khoirilwafi/digital_audio_processor/eagle_pcb/dsp_processor/dlms_v1.brd

## EAGLE design eagle_pcb/dsp_processor/dlms_v1.brd (2023-06-03)

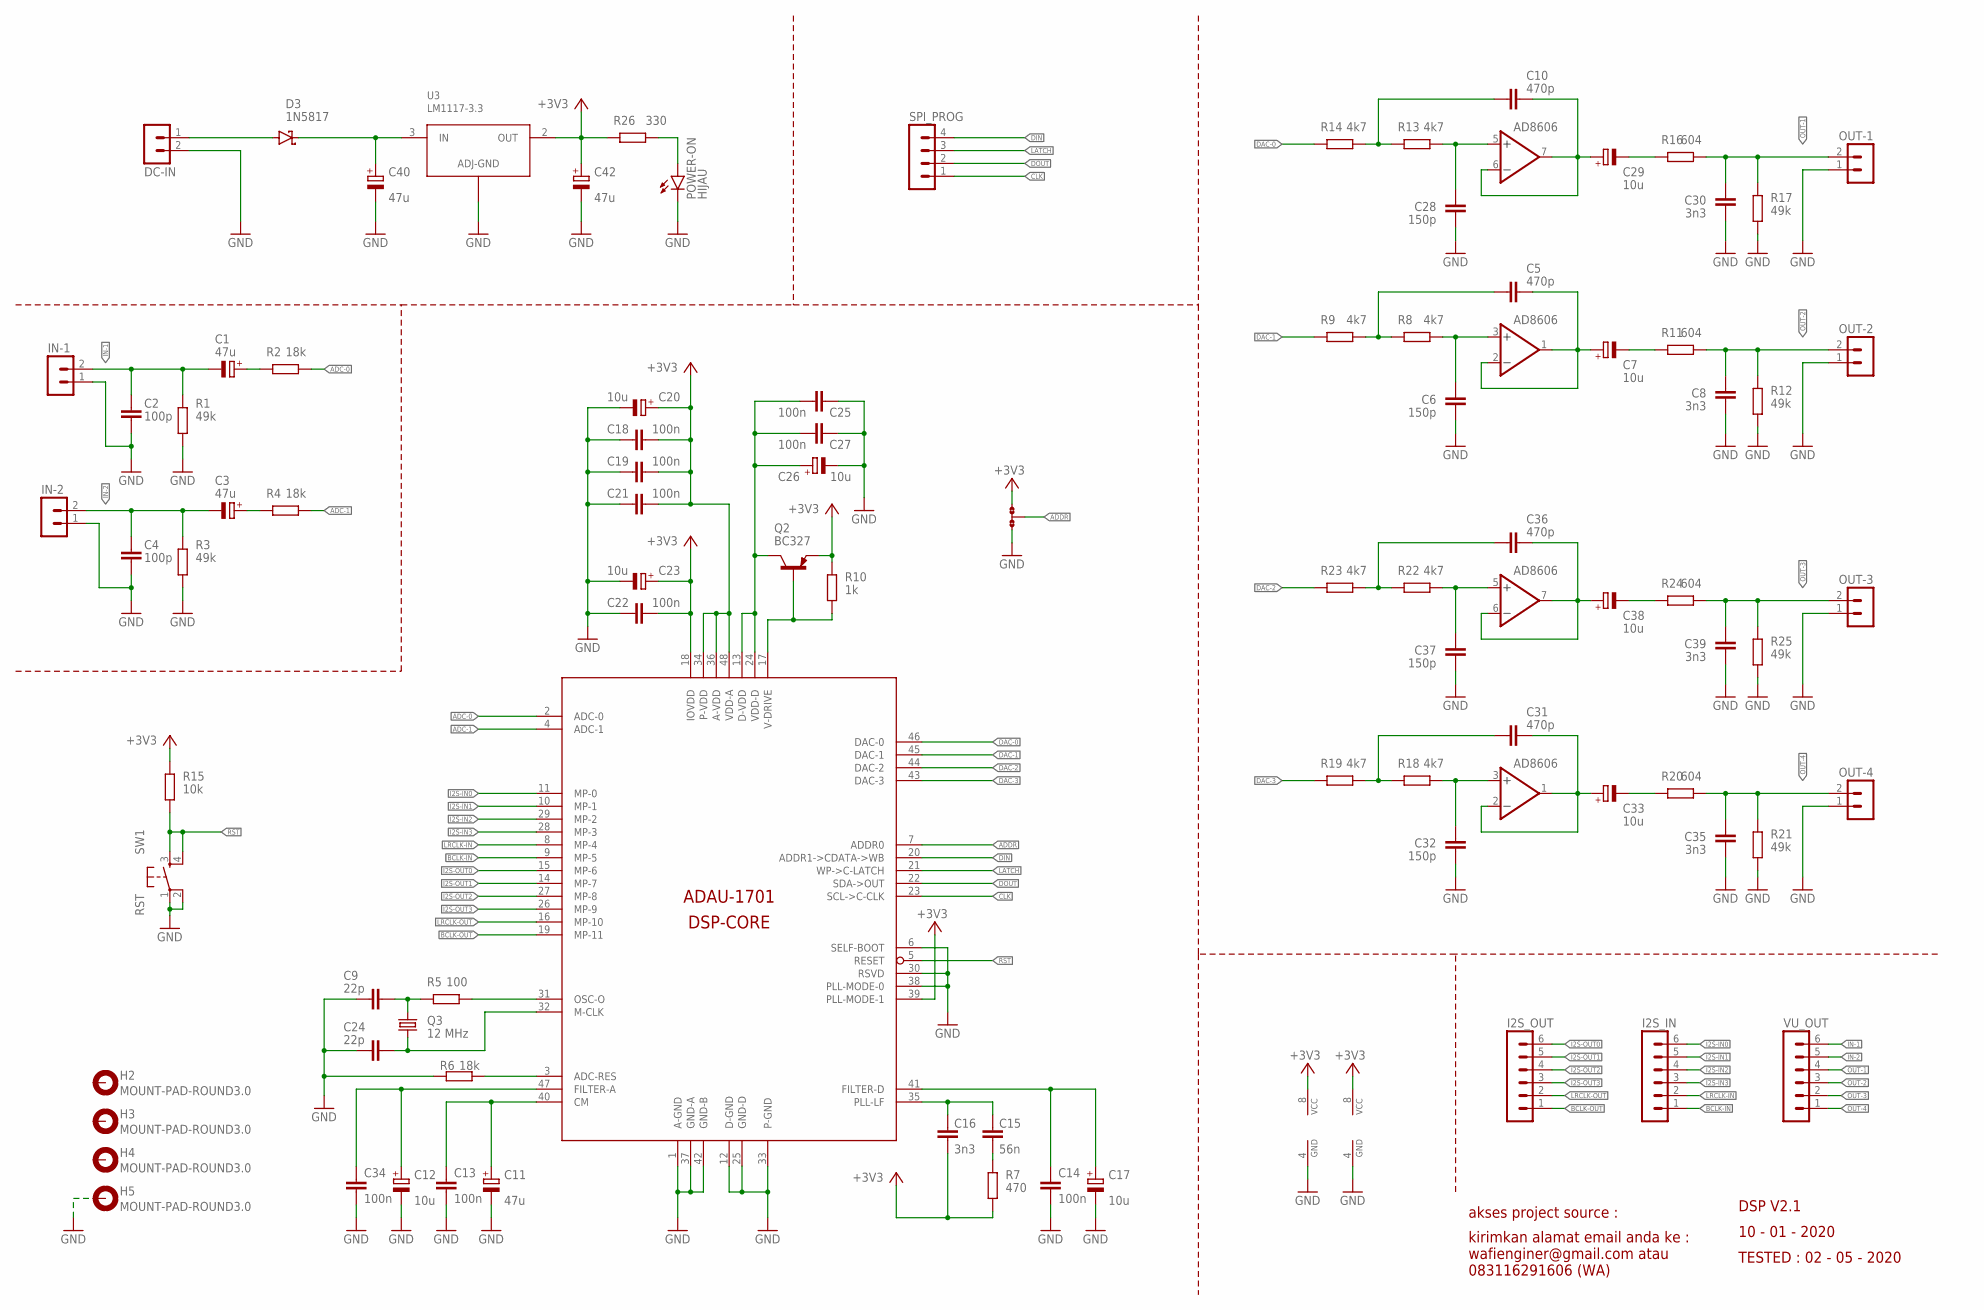
[picture p1: schematic dlms_v1.sch]

Parts:
ADDR: 0R-JUMPA; A0R-JMP
C1, C3, C11, C40, C42: 47u; E2,5-5
C2, C4: 100p; C050-024X044
C5, C10, C31, C36: 470p; C050-024X044
C6, C28, C32, C37: 150p; C050-024X044
C7, C12, C17, C20, C23, C26, C29, C33, C38: 10u; E2,5-5
C8, C16, C30, C35, C39: 3n3; C050-024X044
C9, C24: 22p; 0805
C13, C14, C18, C19, C21, C22, C25, C27, C34: 100n; 0805
C15: 56n; C050-024X044
D3: 1N5817; DO35Z7
DC-IN: MOLEX-2; 6410-02
H2, H3, H4, H5: MOUNT-PAD-ROUND3.0; 3,0-PAD
I2S_IN, I2S_OUT: MOLEX-6; 6410-06
IC1, IC2: AD8606; SOP8
IN-1, IN-2: MOLEX-2; 6410-02
OUT-1, OUT-2, OUT-3, OUT-4: MOLEX-2; 6410-02
POWER-ON: HIJAU; LED3MM
Q2: BC327; TO92-EBC
Q3: 12 MHz; HC49UP
R1, R3, R12, R17, R21, R25: 49k; 0204/7
R2, R4, R6: 18k; 0204/7
R5: 100; 0204/7
R7: 470; 0204/7
R8, R9, R13, R14, R18, R19, R22, R23: 4k7; 0204/7
R10: 1k; 0204/7
R11, R16, R20, R24: 604; 0204/7
R15: 10k; 0204/7
R26: 330; 0204/7
RST: SW1; B3F-10XX
SPI_PROG: MOLEX-4; 6410-04
U1: ADAU-1701; LQFP-48
U3: LM1117-3.3; TO220H
VU_OUT: MOLEX-6; 6410-06

Connections:
+3V3: ADDR.1, C16.2, C18.P$1 (1), C19.P$1 (1), C20.+, C21.P$1 (1), C22.P$1 (1), C23.+, C42.+, IC1.8 (VCC), IC2.8 (VCC), Q2.E, R7.1, R10.2, R15.2, R26.1, U1.18 (IOVDD), U1.34 (P-VDD), U1.36 (A-VDD), U1.39 (PLL-MODE-1), U1.48 (VDD-A), U3.2 (OUT)
ADC-0: R2.2, U1.2 (ADC-0)
ADC-1: R4.2, U1.4 (ADC-1)
ADDR: ADDR.2, U1.7 (ADDR0)
BCLK-IN: I2S_IN.1, U1.9 (MP-5)
BCLK-OUT: I2S_OUT.1, U1.19 (MP-11)
CLK: SPI_PROG.1, U1.23 (SCL->C-CLK)
CM: C11.+, C13.P$1 (1), U1.40 (CM)
DAC-0: R14.1, U1.46 (DAC-0)
DAC-1: R9.1, U1.45 (DAC-1)
DAC-2: R23.1, U1.44 (DAC-2)
DAC-3: R19.1, U1.43 (DAC-3)
DIN: SPI_PROG.4, U1.20 (ADDR1->CDATA->WB)
DOUT: SPI_PROG.2, U1.22 (SDA->OUT)
DVDD: C25.P$1 (1), C26.+, C27.P$1 (1), Q2.C, U1.13 (D-VDD), U1.24 (VDD-D)
FIL-A: C12.+, C34.P$1 (1), U1.47 (FILTER-A)
FIL-D: C14.P$1 (1), C17.+, U1.41 (FILTER-D)
GND: ADDR.3, C2.2, C4.2, C6.1, C8.2, C9.P$2 (2), C11.-, C12.-, C13.P$2 (2), C14.P$2 (2), C17.-, C18.P$2 (2), C19.P$2 (2), C20.-, C21.P$2 (2), C22.P$2 (2), C23.-, C24.P$2 (2), C25.P$2 (2), C26.-, C27.P$2 (2), C28.1, C30.2, C32.1, C34.P$2 (2), C35.2, C37.1, C39.2, C40.-, C42.-, DC-IN.2, H5.B3,0, IC1.4 (GND), IC2.4 (GND), IN-1.1, IN-2.1, OUT-1.1, OUT-2.1, OUT-3.1, OUT-4.1, POWER-ON.K (C), R1.1, R3.1, R6.1, R12.1, R17.1, R21.1, R25.1, RST.1, RST.2 (P1), U1.1 (A-GND), U1.6 (SELF-BOOT), U1.12 (D-GND), U1.25 (GND-D), U1.30 (RSVD), U1.33 (P-GND), U1.37 (GND-A), U1.38 (PLL-MODE-0), U1.42 (GND-B), U3.1 (GND)
I2S-IN0: I2S_IN.6, U1.11 (MP-0)
I2S-IN1: I2S_IN.5, U1.10 (MP-1)
I2S-IN2: I2S_IN.4, U1.29 (MP-2)
I2S-IN3: I2S_IN.3, U1.28 (MP-3)
I2S-OUT0: I2S_OUT.6, U1.15 (MP-6)
I2S-OUT1: I2S_OUT.5, U1.14 (MP-7)
I2S-OUT2: I2S_OUT.4, U1.27 (MP-8)
I2S-OUT3: I2S_OUT.3, U1.26 (MP-9)
IN-1: C1.-, C2.1, IN-1.2, R1.2, VU_OUT.6
IN-2: C3.-, C4.1, IN-2.2, R3.2, VU_OUT.5
LATCH: SPI_PROG.3, U1.21 (WP->C-LATCH)
LRCLK-IN: I2S_IN.2, U1.8 (MP-4)
LRCLK-OUT: I2S_OUT.2, U1.16 (MP-10)
unnamed: C1.+, R2.1
unnamed: C3.+, R4.1
unnamed: C5.1, R8.1, R9.2
unnamed: C6.2, IC1.3 (+IN), R8.2
unnamed: C5.2, C7.+, IC1.1 (OUT), IC1.2 (-IN)
unnamed: C7.-, R11.1
unnamed: C10.1, R13.1, R14.2
unnamed: C9.P$1 (1), Q3.2, R5.1
unnamed: C24.P$1 (1), Q3.1, U1.32 (M-CLK)
unnamed: R5.2, U1.31 (OSC-O)
unnamed: C28.2, IC1.5 (+IN), R13.2
unnamed: C10.2, C29.+, IC1.6 (-IN), IC1.7 (OUT)
unnamed: R6.2, U1.3 (ADC-RES)
unnamed: C29.-, R16.1
unnamed: C15.2, R7.2
unnamed: C31.1, R18.1, R19.2
unnamed: C32.2, IC2.3 (+IN), R18.2
unnamed: C31.2, C33.+, IC2.1 (OUT), IC2.2 (-IN)
unnamed: C33.-, R20.1
unnamed: C36.1, R22.1, R23.2
unnamed: C37.2, IC2.5 (+IN), R22.2
unnamed: C36.2, C38.+, IC2.6 (-IN), IC2.7 (OUT)
unnamed: C38.-, R24.1
unnamed: C40.+, D3.C, U3.3 (IN)
unnamed: POWER-ON.A, R26.2
OUT-1: C30.1, OUT-1.2, R16.2, R17.2, VU_OUT.4
OUT-2: C8.1, OUT-2.2, R11.2, R12.2, VU_OUT.3
OUT-3: C39.1, OUT-3.2, R24.2, R25.2, VU_OUT.2
OUT-4: C35.1, OUT-4.2, R20.2, R21.2, VU_OUT.1
PLL-LF: C15.1, C16.1, U1.35 (PLL-LF)
RST: R15.1, RST.3 (S), RST.4 (S1), U1.5 (RESET)
VDRIVE: Q2.B, R10.1, U1.17 (V-DRIVE)
VIN: D3.A, DC-IN.1

Notes on the sheet:
akses project source :
kirimkan alamat email anda ke : wafienginer@gmail.com atau 083116291606 (WA)
DSP V2.1
10 - 01 - 2020
TESTED : 02 - 05 - 2020

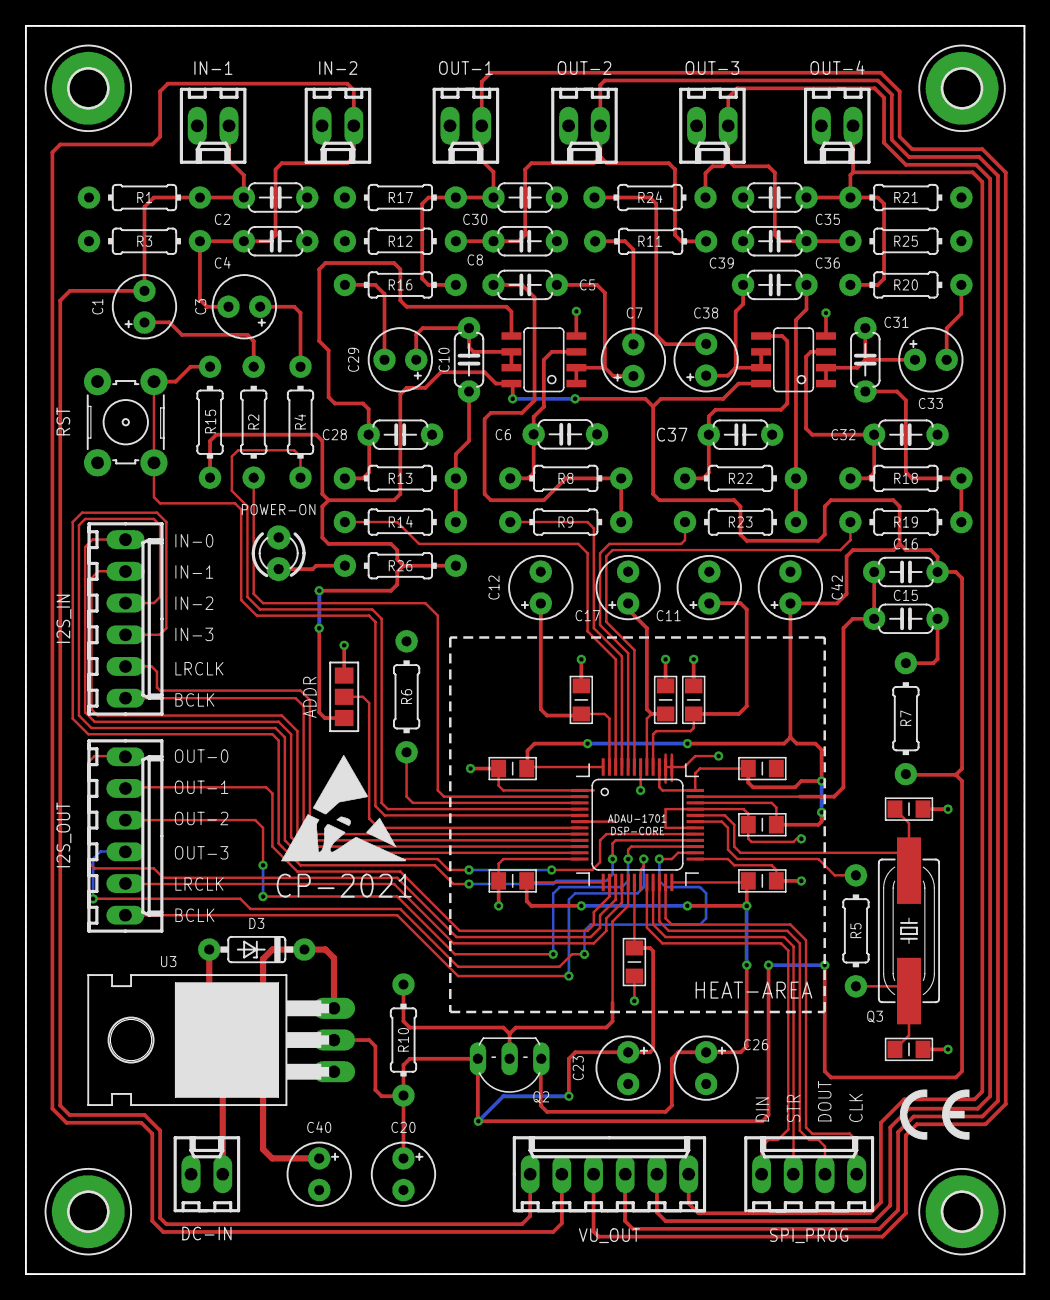
[picture p2: board dlms_v1.brd from above]

Board: 2 copper layers, 80.0 x 100.0 mm, 94 parts (0 on the bottom side), 64 nets.

Other parts of the board:
U$2: CE-4MM
U$3: ESD_10.00
