khoirilwafi/digital_audio_processor/eagle_pcb/dsp_controller/control.brd

## EAGLE design eagle_pcb/dsp_controller/control.brd (2023-06-03)

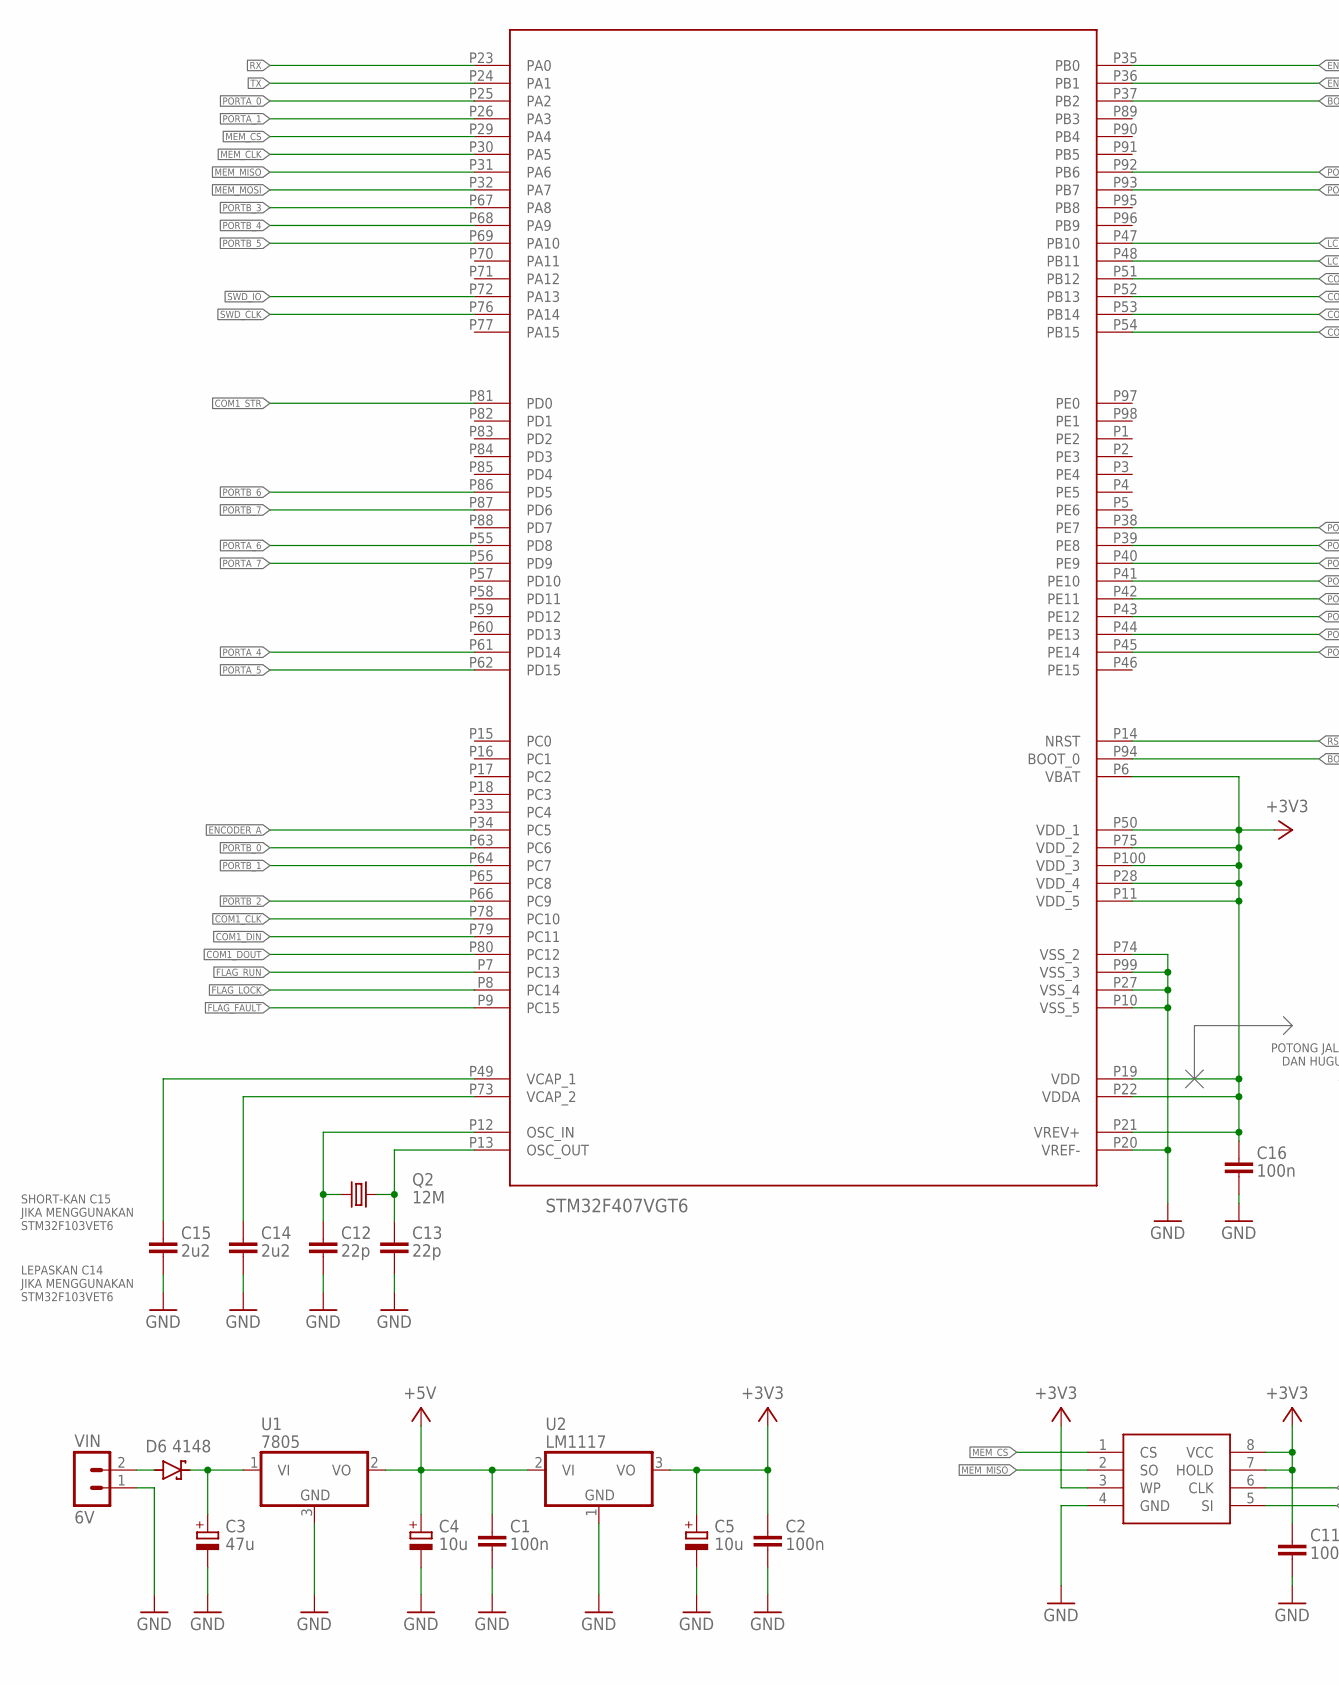
[picture p3: schematic control.sch, part in row 1, column 1]

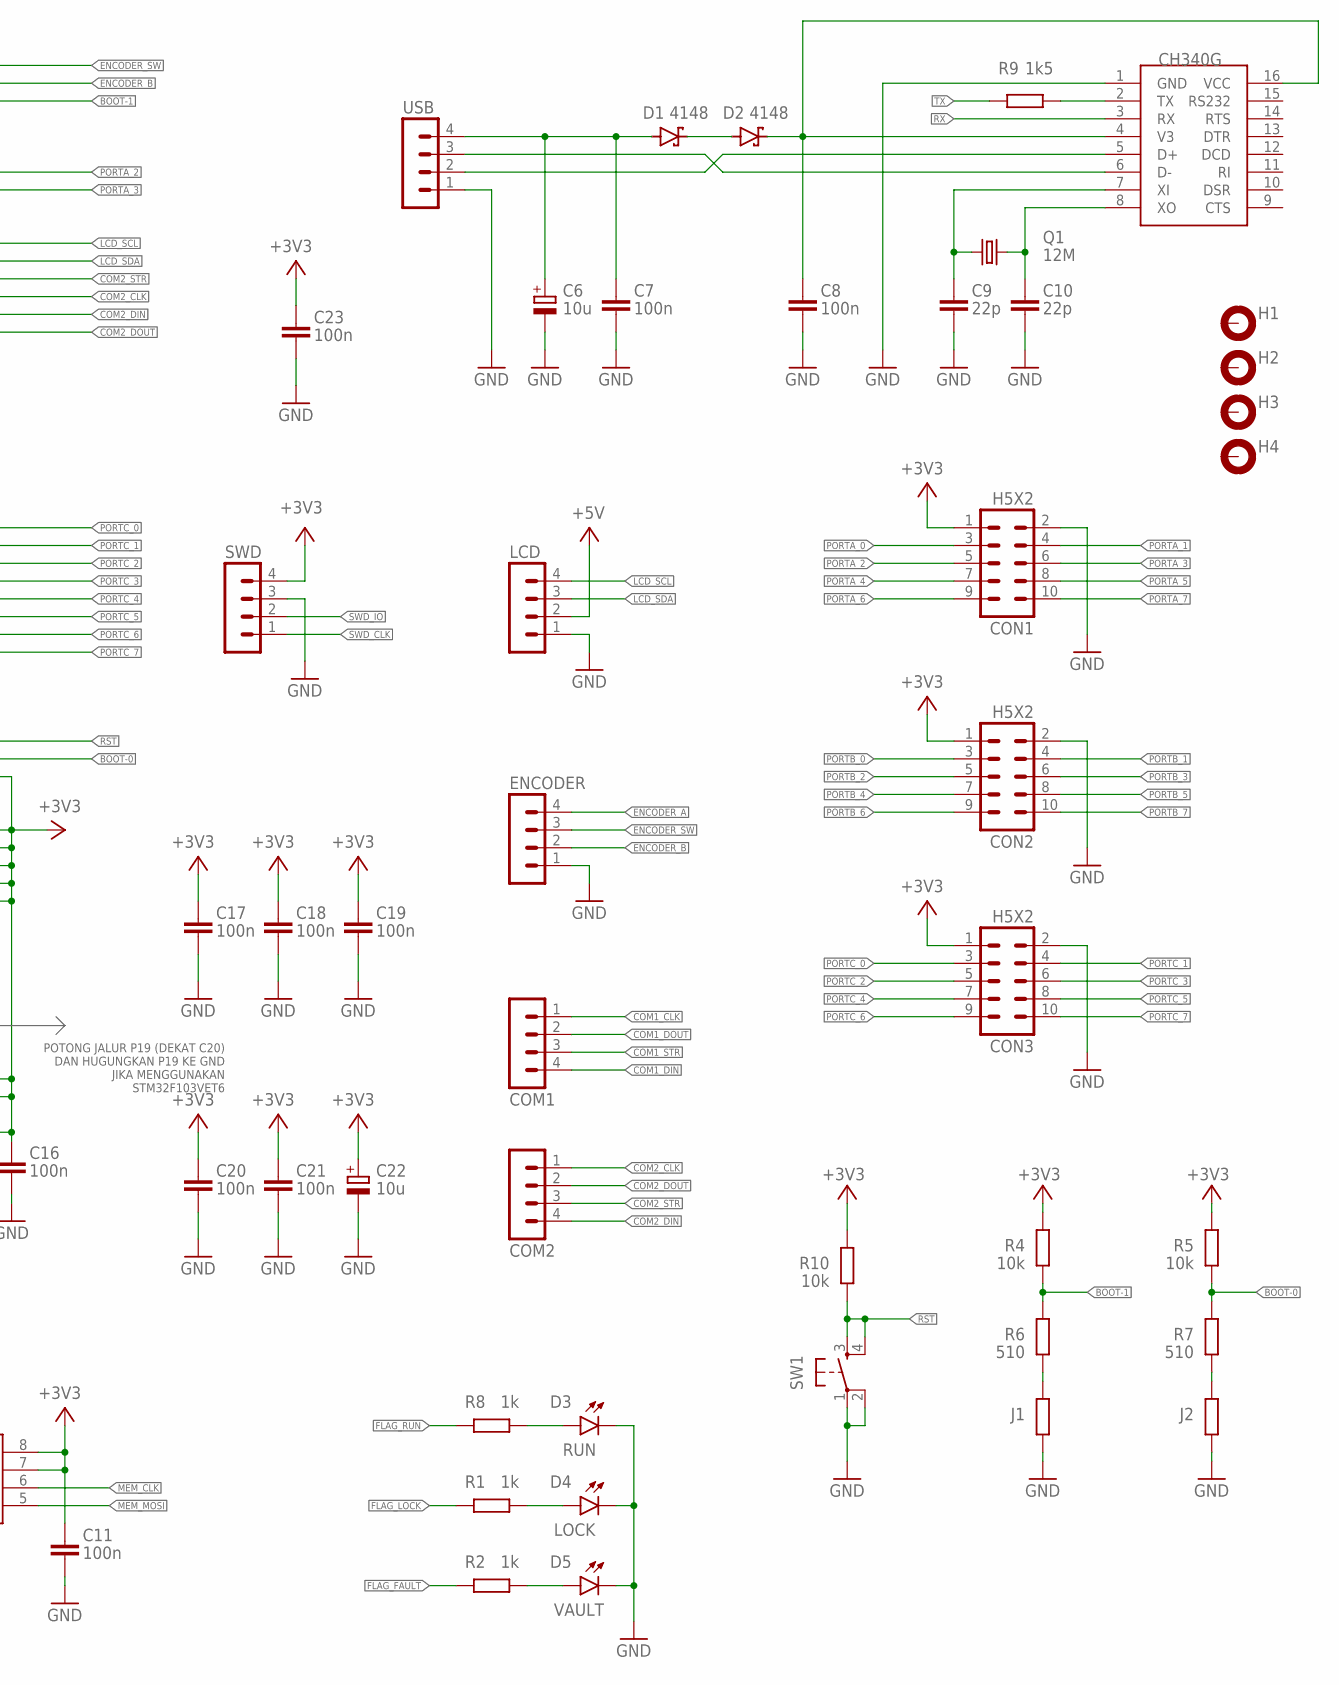
[picture p4: schematic control.sch, part in row 1, column 2]

Parts:
C1, C2, C7, C8, C11, C16, C17, C18, C19, C20, C21, C23: 100n; 0805
C3: 47u; E2,5-5
C4, C5, C6, C22: 10u; E2,5-5
C9, C10, C12, C13: 22p; 0805
C14, C15: 2u2; 0805
COM1, COM2: MOLEX-4; 6410-04
CON1, CON2, CON3: H5X2; MA05-2
D1, D2, D6: 4148; DO35Z7
D3: RUN; LED3MM
D4: LOCK; LED3MM
D5: VAULT; LED3MM
ENCODER: MOLEX-4; 6410-04
H1, H2, H3, H4: MOUNT-PAD-ROUND3.0; 3,0-PAD
J1, J2: 10k; 0805
LCD: MOLEX-4; 6410-04
Q1, Q2: 12M; HC49/S
R1, R2, R8: 1k; 0805
R4, R5, R10: 10k; 0805
R6, R7: 510; 0805
R9: 1k5; 0204/7
SW1: SW; B3F-10XX
SWD: MOLEX-4; 6410-04
U1: 7805; TO252
U2: LM1117; TO252
U3: W25QXX; SOP8
U4: STM32F407; LQFP100
U$1: CH340G; SOIC16
USB: MOLEX-4; 6410-04
VIN: 6V; 6410-02

Connections:
+3V3: C2.P$1 (1), C5.+, C11.P$1 (1), C16.P$1 (1), C17.P$1 (1), C18.P$1 (1), C19.P$1 (1), C20.P$1 (1), C21.P$1 (1), C22.+, C23.P$1 (1), CON1.1, CON2.1, CON3.1, R4.P$2 (2), R5.P$2 (2), R10.P$2 (2), SWD.4, U2.3 (VO), U3.3 (WP), U3.7 (HOLD), U3.8 (VCC), U4.P6 (VBAT), U4.P11 (VDD_5), U4.P19 (VDD), U4.P21 (VREV+), U4.P22 (VDDA), U4.P28 (VDD_4), U4.P50 (VDD_1), U4.P75 (VDD_2), U4.P100 (VDD_3)
+5V: C1.P$1 (1), C4.+, LCD.2, U1.2 (VO), U2.2 (VI)
BOOT-0: R5.P$1 (1), R7.P$2 (2), U4.P94 (BOOT_0)
BOOT-1: R4.P$1 (1), R6.P$2 (2), U4.P37 (PB2)
COM1_CLK: COM1.1, U4.P78 (PC10)
COM1_DIN: COM1.4, U4.P79 (PC11)
COM1_DOUT: COM1.2, U4.P80 (PC12)
COM1_STR: COM1.3, U4.P81 (PD0)
COM2_CLK: COM2.1, U4.P52 (PB13)
COM2_DIN: COM2.4, U4.P53 (PB14)
COM2_DOUT: COM2.2, U4.P54 (PB15)
COM2_STR: COM2.3, U4.P51 (PB12)
ENCODER_A: ENCODER.4, U4.P34 (PC5)
ENCODER_B: ENCODER.2, U4.P36 (PB1)
ENCODER_SW: ENCODER.3, U4.P35 (PB0)
FLAG_FAULT: R2.P$2 (2), U4.P9 (PC15)
FLAG_LOCK: R1.P$2 (2), U4.P8 (PC14)
FLAG_RUN: R8.P$2 (2), U4.P7 (PC13)
GND: C1.P$2 (2), C2.P$2 (2), C3.-, C4.-, C5.-, C6.-, C7.P$2 (2), C8.P$2 (2), C9.P$2 (2), C10.P$2 (2), C11.P$2 (2), C12.P$2 (2), C13.P$2 (2), C14.P$2 (2), C15.P$2 (2), C16.P$2 (2), C17.P$2 (2), C18.P$2 (2), C19.P$2 (2), C20.P$2 (2), C21.P$2 (2), C22.-, C23.P$2 (2), CON1.2, CON2.2, CON3.2, D3.K (C), D4.K (C), D5.K (C), ENCODER.1, J1.P$1 (1), J2.P$1 (1), LCD.1, SW1.1, SW1.2 (P1), SWD.3, U1.3 (GND), U2.1 (GND), U3.4 (GND), U4.P10 (VSS_5), U4.P20 (VREF-), U4.P27 (VSS_4), U4.P74 (VSS_2), U4.P99 (VSS_3), U$1.1 (GND), USB.1, VIN.1
LCD_SCL: LCD.4, U4.P47 (PB10)
LCD_SDA: LCD.3, U4.P48 (PB11)
MEM_CLK: U3.6 (CLK), U4.P30 (PA5)
MEM_CS: U3.1 (CS), U4.P29 (PA4)
MEM_MISO: U3.2 (SO), U4.P31 (PA6)
MEM_MOSI: U3.5 (SI), U4.P32 (PA7)
unnamed: C3.+, D6.C, U1.1 (VI)
unnamed: C6.+, C7.P$1 (1), D1.A, USB.4
unnamed: D1.C, D2.A
unnamed: C8.P$1 (1), D2.C, U$1.4 (V3), U$1.16 (VCC)
unnamed: U$1.6 (D-), USB.3
unnamed: U$1.5 (D+), USB.2
unnamed: C9.P$1 (1), Q1.1, U$1.7 (XI)
unnamed: C10.P$1 (1), Q1.2, U$1.8 (XO)
unnamed: D5.A, R2.P$1 (1)
unnamed: D4.A, R1.P$1 (1)
unnamed: D3.A, R8.P$1 (1)
unnamed: C12.P$1 (1), Q2.1, U4.P12 (OSC_IN)
unnamed: C13.P$1 (1), Q2.2, U4.P13 (OSC_OUT)
unnamed: C14.P$1 (1), U4.P73 (VCAP_2)
unnamed: C15.P$1 (1), U4.P49 (VCAP_1)
unnamed: D6.A, VIN.2
unnamed: J1.P$2 (2), R6.P$1 (1)
unnamed: J2.P$2 (2), R7.P$1 (1)
unnamed: R9.2, U$1.2 (TX)
PORTA_0: CON1.3, U4.P25 (PA2)
PORTA_1: CON1.4, U4.P26 (PA3)
PORTA_2: CON1.5, U4.P92 (PB6)
PORTA_3: CON1.6, U4.P93 (PB7)
PORTA_4: CON1.7, U4.P61 (PD14)
PORTA_5: CON1.8, U4.P62 (PD15)
PORTA_6: CON1.9, U4.P55 (PD8)
PORTA_7: CON1.10, U4.P56 (PD9)
PORTB_0: CON2.3, U4.P63 (PC6)
PORTB_1: CON2.4, U4.P64 (PC7)
PORTB_2: CON2.5, U4.P66 (PC9)
PORTB_3: CON2.6, U4.P67 (PA8)
PORTB_4: CON2.7, U4.P68 (PA9)
PORTB_5: CON2.8, U4.P69 (PA10)
PORTB_6: CON2.9, U4.P86 (PD5)
PORTB_7: CON2.10, U4.P87 (PD6)
PORTC_0: CON3.3, U4.P38 (PE7)
PORTC_1: CON3.4, U4.P39 (PE8)
PORTC_2: CON3.5, U4.P40 (PE9)
PORTC_3: CON3.6, U4.P41 (PE10)
PORTC_4: CON3.7, U4.P42 (PE11)
PORTC_5: CON3.8, U4.P43 (PE12)
PORTC_6: CON3.9, U4.P44 (PE13)
PORTC_7: CON3.10, U4.P45 (PE14)
RST: R10.P$1 (1), SW1.3 (S), SW1.4 (S1), U4.P14 (NRST)
RX: U4.P23 (PA0), U$1.3 (RX)
SWD_CLK: SWD.1, U4.P76 (PA14)
SWD_IO: SWD.2, U4.P72 (PA13)
TX: R9.1, U4.P24 (PA1)

Notes on the sheet:
STM32F407VGT6
SHORT-KAN C15 JIKA MENGGUNAKAN STM32F103VET6
LEPASKAN C14 JIKA MENGGUNAKAN STM32F103VET6
POTONG JALUR P19 (DEKAT C20) DAN HUGUNGKAN P19 KE GND JIKA MENGGUNAKAN STM32F103VET6

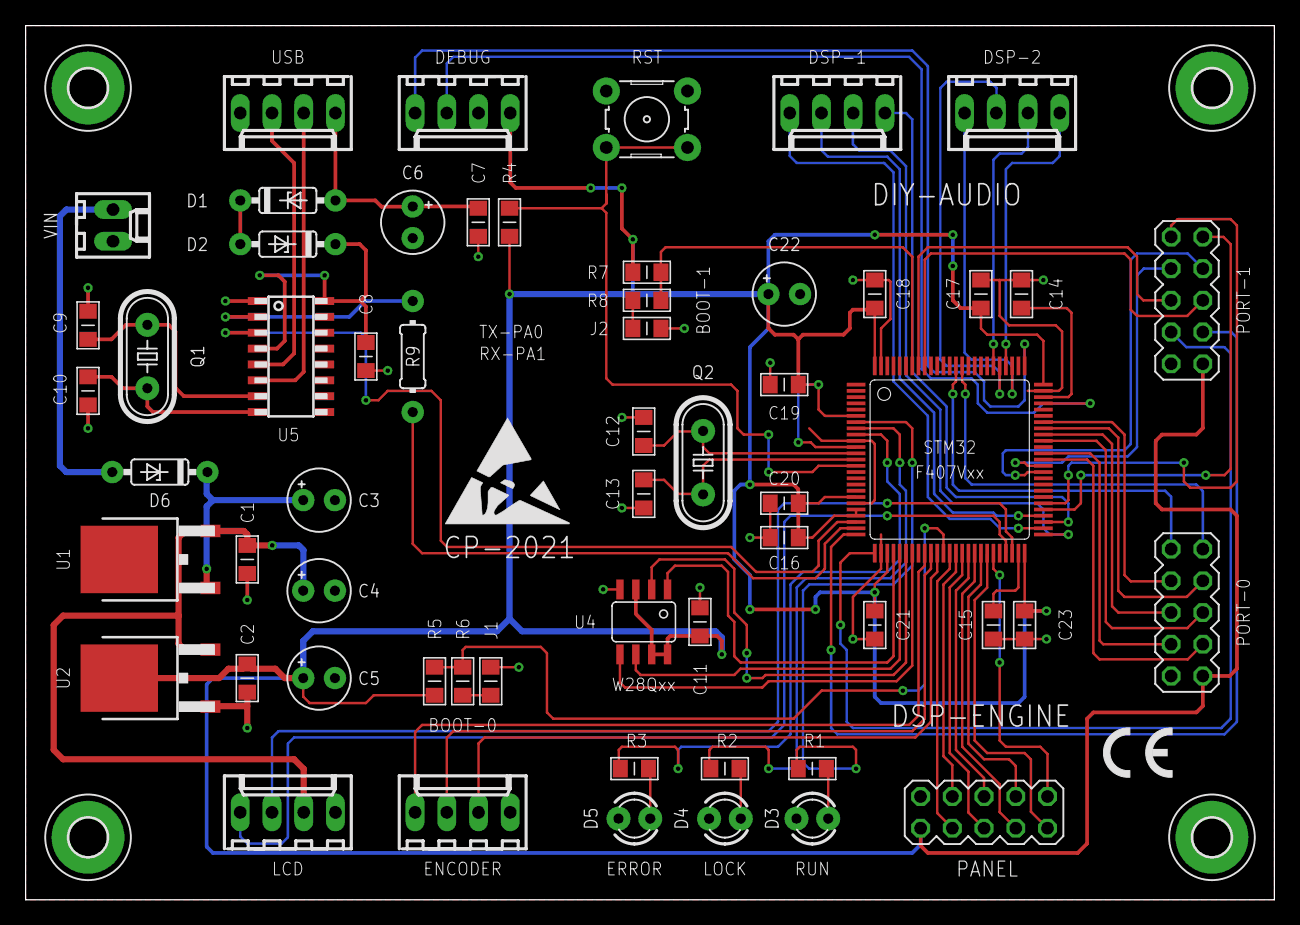
[picture p5: board control.brd from above]

Board: 2 copper layers, 100.0 x 70.0 mm, 64 parts (0 on the bottom side), 73 nets.

Other parts of the board:
E$1: ESD_10.00
U$2: CE-4MM
