khoirilwafi/digital_audio_processor/stm32/new_module/Core/Src/main.c

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
/* Includes ------------------------------------------------------------------*/
#include "main.h"

/* USER CODE BEGIN Includes */
#include "lcd_16x2_i2c.h"
#include "interface.h"
#include "dsp_processor.h"
#include "internal_data.h"
#include "external_flash.h"
/* USER CODE END Includes */

I2C_HandleTypeDef hi2c2;

SPI_HandleTypeDef hspi1;
SPI_HandleTypeDef hspi2;

TIM_HandleTypeDef htim1;
TIM_HandleTypeDef htim2;

/* USER CODE BEGIN PV */
extern int8_t mod;
extern uint8_t channel;
extern uint8_t page, sub_page;
extern uint8_t pos, prev, layer;
extern bool lcd_refresh;
extern bool setting;
extern bool mute[6];
/* USER CODE END PV */

void SystemClock_Config(void);
static void MX_GPIO_Init(void);
static void MX_I2C2_Init(void);
static void MX_SPI2_Init(void);
static void MX_SPI1_Init(void);
static void MX_TIM1_Init(void);
static void MX_TIM2_Init(void);
/**
  * @brief  The application entry point.
  * @retval int
  */
int main(void)
{
  /* MCU Configuration--------------------------------------------------------*/

  /* Reset of all peripherals, Initializes the Flash interface and the Systick. */
  HAL_Init();

  /* Configure the system clock */
  SystemClock_Config();

  /* Initialize all configured peripherals */
  MX_GPIO_Init();
  MX_I2C2_Init();
  MX_SPI2_Init();
  MX_SPI1_Init();
  MX_TIM1_Init();
  MX_TIM2_Init();
  /* USER CODE BEGIN 2 */

  HAL_GPIO_WritePin(LOCK_GPIO_Port, LOCK_Pin, GPIO_PIN_SET);
  HAL_GPIO_WritePin(ERROR_GPIO_Port, ERROR_Pin, GPIO_PIN_SET);
  HAL_GPIO_WritePin(RUN_GPIO_Port, RUN_Pin, GPIO_PIN_SET);

	HAL_Delay(500);
	HAL_GPIO_WritePin(DSP_RST_GPIO_Port, DSP_RST_Pin, GPIO_PIN_RESET);
	HAL_Delay(500);
	HAL_GPIO_WritePin(DSP_RST_GPIO_Port, DSP_RST_Pin, GPIO_PIN_SET);

	interface_begin();
	loading_procedure();

	HAL_TIM_Base_Start_IT(&htim2);
	HAL_Delay(500);

  	// cek koneksi lcd
  	uint8_t ret = HAL_I2C_IsDeviceReady(&hi2c2, 0x27<<1, 10, 100);

  	if(ret != HAL_OK)
  	{
  		Error_Handler();
  	}

  	uint16_t id = flash_read_id();

  	if((id == 0x00) || (id != 0xEF17))
  	{
  		lcd_clear();
  		lcd_set_cursor(0,0); lcd_print("ERROR FLASH");
  		lcd_set_cursor(0,1); lcd_print("TIDAK DITEMUKAN");

  		Error_Handler();
  	}

  	uint32_t handshake[4] = { 0x00, 0x18, 0x08, 0x00 };

  	for(uint8_t i=0; i<4; i++)
  	{
  		if(flash_read_byte(0x020000+i) != handshake[i])
  		{
  			lcd_clear();
  			lcd_set_cursor(0,0); lcd_print("ERROR");
  			lcd_set_cursor(0,1); lcd_print("FLASH CORRUPT");

  			Error_Handler();
  		}
  	}

  	// cek koneksi dsp
  	if(dsp_check_connection(0) != HAL_OK)
  	{
  		lcd_clear();
  		lcd_set_cursor(0,0); lcd_print("ERROR DSP");
  		lcd_set_cursor(0,1); lcd_print("TIDAK DITEMUKAN");

  		Error_Handler();
  	}

  	HAL_GPIO_WritePin(RUN_GPIO_Port, RUN_Pin, GPIO_PIN_SET);

  	lcd_clear();
  	interface_welcome();
  	dsp_unmute(0);

  	led_sel(0);
  	for(uint8_t i=0; i<6; i++)
  	{
  		led_mute(i, mute[i]);
  	}

  /* USER CODE END 2 */

  /* Infinite loop */
  /* USER CODE BEGIN WHILE */
  while (1)
  {
	  uint8_t nilai_tombol = baca_tombol();
	      	while(baca_tombol() != 0);

	      	switch(nilai_tombol)
	      	{
	  	  		case 1 : channel = 0; page = 1; sub_page = pos = 0; prev = 1; led_sel(0); lcd_refresh = true; lcd_clear(); break;
	  	  		case 2 : channel = 1; page = 1; sub_page = pos = 0; prev = 1; led_sel(1); lcd_refresh = true; lcd_clear(); break;
	  	  		case 3 : channel = 2; page = 2; sub_page = pos = 0; prev = 1; led_sel(2); lcd_refresh = true; lcd_clear(); break;
	  	  		case 4 : channel = 3; page = 2; sub_page = pos = 0; prev = 1; led_sel(3); lcd_refresh = true; lcd_clear(); break;
	  	  		case 5 : channel = 4; page = 2; sub_page = pos = 0; prev = 1; led_sel(4); lcd_refresh = true; lcd_clear(); break;
	  	  		case 6 : channel = 5; page = 2; sub_page = pos = 0; prev = 1; led_sel(5); lcd_refresh = true; lcd_clear(); break;
	  	  		case 7 :
	  	  			if(sub_page == 0)
	  	  			{
	  	  				if(mute[channel] == true){ mute[channel] = false; }
	  	  				else{ mute[channel] = true; }
	  	  				lcd_refresh = true;
	  	  			}
	  	  		break;
	  	  		case 8 :
	  	  			reset_parameter();
	  	  		break;
	  	  		case 9 :
	  	  			if(sub_page == 0){ sub_page = 1; }
	  	  			else{ sub_page = 0; }
	  	  			setting = false;
	  	  			lcd_refresh = true;
	  	  			lcd_clear();
	  	  		break;
	  	  		case 10 :
	  	  			save_parameter();
	  	  		break;
	      	}

	      	switch(page)
	      	{
	  	  		case 1 : page1(); break;
	  	  		case 2 : page2(); break;
	      	}
    /* USER CODE END WHILE */

    /* USER CODE BEGIN 3 */
  }
  /* USER CODE END 3 */
}

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
