khoirilwafi/digital_audio_processor/sigma_studio/dlms_fix_IC_1_PARAM.h

/*
 * File:           D:\final_project_file\audio_management\sigma_studio\dlms_fix_IC_1_PARAM.h
 *
 * Created:        Monday, June 28, 2021 9:38:38 AM
 * Description:    dlms_fix:IC 1 parameter RAM definitions.
 *
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
 * This software may only be used to program products purchased from
 * Analog Devices for incorporation by you into audio products that
 * are intended for resale to audio product end users. This software
 * may not be distributed whole or in any part to third parties.
 *
 * Copyright ©2021 Analog Devices, Inc. All rights reserved.
 */
#ifndef __DLMS_FIX_IC_1_PARAM_H__
#define __DLMS_FIX_IC_1_PARAM_H__


/* Module Gain_input1 - Gain*/
#define MOD_GAIN_INPUT1_COUNT                          1
#define MOD_GAIN_INPUT1_DEVICE                         "IC1"
#define MOD_GAIN_INPUT1_GAIN1940ALGNS2_ADDR            0
#define MOD_GAIN_INPUT1_GAIN1940ALGNS2_FIXPT           0x00800000
#define MOD_GAIN_INPUT1_GAIN1940ALGNS2_VALUE           SIGMASTUDIOTYPE_FIXPOINT_CONVERT(1)
#define MOD_GAIN_INPUT1_GAIN1940ALGNS2_TYPE            SIGMASTUDIOTYPE_FIXPOINT

/* Module Gain1_input2 - Gain*/
#define MOD_GAIN1_INPUT2_COUNT                         1
#define MOD_GAIN1_INPUT2_DEVICE                        "IC1"
#define MOD_GAIN1_INPUT2_GAIN1940ALGNS1_ADDR           1
#define MOD_GAIN1_INPUT2_GAIN1940ALGNS1_FIXPT          0x00800000
#define MOD_GAIN1_INPUT2_GAIN1940ALGNS1_VALUE          SIGMASTUDIOTYPE_FIXPOINT_CONVERT(1)
#define MOD_GAIN1_INPUT2_GAIN1940ALGNS1_TYPE           SIGMASTUDIOTYPE_FIXPOINT

/* Module DCB2 - DC Blocking*/
#define MOD_DCB2_COUNT                                 1
#define MOD_DCB2_DEVICE                                "IC1"
#define MOD_DCB2_DCBLOCKALGDOUBLEPREC2POLE_ADDR        2
#define MOD_DCB2_DCBLOCKALGDOUBLEPREC2POLE_FIXPT       0x007FFCB9
#define MOD_DCB2_DCBLOCKALGDOUBLEPREC2POLE_VALUE       SIGMASTUDIOTYPE_FIXPOINT_CONVERT(0.9999)
#define MOD_DCB2_DCBLOCKALGDOUBLEPREC2POLE_TYPE        SIGMASTUDIOTYPE_FIXPOINT

/* Module DCB2_2 - DC Blocking*/
#define MOD_DCB2_2_COUNT                               1
#define MOD_DCB2_2_DEVICE                              "IC1"
#define MOD_DCB2_2_DCBLOCKALGDOUBLEPREC1POLE_ADDR      3
#define MOD_DCB2_2_DCBLOCKALGDOUBLEPREC1POLE_FIXPT     0x007FFCB9
#define MOD_DCB2_2_DCBLOCKALGDOUBLEPREC1POLE_VALUE     SIGMASTUDIOTYPE_FIXPOINT_CONVERT(0.9999)
#define MOD_DCB2_2_DCBLOCKALGDOUBLEPREC1POLE_TYPE      SIGMASTUDIOTYPE_FIXPOINT

/* Module EQ-input1 - Parametric EQ*/
#define MOD_EQ_INPUT1_COUNT                            20
#define MOD_EQ_INPUT1_DEVICE                           "IC1"
#define MOD_EQ_INPUT1_ALG0_STAGE0_B0_ADDR              4
#define MOD_EQ_INPUT1_ALG0_STAGE0_B0_FIXPT             0x00800000
#define MOD_EQ_INPUT1_ALG0_STAGE0_B0_VALUE             SIGMASTUDIOTYPE_FIXPOINT_CONVERT(1)
#define MOD_EQ_INPUT1_ALG0_STAGE0_B0_TYPE              SIGMASTUDIOTYPE_FIXPOINT
#define MOD_EQ_INPUT1_ALG0_STAGE0_B1_ADDR              5
#define MOD_EQ_INPUT1_ALG0_STAGE0_B1_FIXPT             0x00000000
#define MOD_EQ_INPUT1_ALG0_STAGE0_B1_VALUE             SIGMASTUDIOTYPE_FIXPOINT_CONVERT(0)
#define MOD_EQ_INPUT1_ALG0_STAGE0_B1_TYPE              SIGMASTUDIOTYPE_FIXPOINT
#define MOD_EQ_INPUT1_ALG0_STAGE0_B2_ADDR              6
#define MOD_EQ_INPUT1_ALG0_STAGE0_B2_FIXPT             0x00000000
#define MOD_EQ_INPUT1_ALG0_STAGE0_B2_VALUE             SIGMASTUDIOTYPE_FIXPOINT_CONVERT(0)
#define MOD_EQ_INPUT1_ALG0_STAGE0_B2_TYPE              SIGMASTUDIOTYPE_FIXPOINT
#define MOD_EQ_INPUT1_ALG0_STAGE0_A0_ADDR              7
#define MOD_EQ_INPUT1_ALG0_STAGE0_A0_FIXPT             0x00000000
#define MOD_EQ_INPUT1_ALG0_STAGE0_A0_VALUE             SIGMASTUDIOTYPE_FIXPOINT_CONVERT(0)
#define MOD_EQ_INPUT1_ALG0_STAGE0_A0_TYPE              SIGMASTUDIOTYPE_FIXPOINT
#define MOD_EQ_INPUT1_ALG0_STAGE0_A1_ADDR              8
#define MOD_EQ_INPUT1_ALG0_STAGE0_A1_FIXPT             0x00000000
#define MOD_EQ_INPUT1_ALG0_STAGE0_A1_VALUE             SIGMASTUDIOTYPE_FIXPOINT_CONVERT(0)
#define MOD_EQ_INPUT1_ALG0_STAGE0_A1_TYPE              SIGMASTUDIOTYPE_FIXPOINT
#define MOD_EQ_INPUT1_ALG0_STAGE1_B0_ADDR              9
#define MOD_EQ_INPUT1_ALG0_STAGE1_B0_FIXPT             0x00800000
#define MOD_EQ_INPUT1_ALG0_STAGE1_B0_VALUE             SIGMASTUDIOTYPE_FIXPOINT_CONVERT(1)
#define MOD_EQ_INPUT1_ALG0_STAGE1_B0_TYPE              SIGMASTUDIOTYPE_FIXPOINT
#define MOD_EQ_INPUT1_ALG0_STAGE1_B1_ADDR              10
#define MOD_EQ_INPUT1_ALG0_STAGE1_B1_FIXPT             0x00000000
#define MOD_EQ_INPUT1_ALG0_STAGE1_B1_VALUE             SIGMASTUDIOTYPE_FIXPOINT_CONVERT(0)
#define MOD_EQ_INPUT1_ALG0_STAGE1_B1_TYPE              SIGMASTUDIOTYPE_FIXPOINT
#define MOD_EQ_INPUT1_ALG0_STAGE1_B2_ADDR              11
#define MOD_EQ_INPUT1_ALG0_STAGE1_B2_FIXPT             0x00000000
#define MOD_EQ_INPUT1_ALG0_STAGE1_B2_VALUE             SIGMASTUDIOTYPE_FIXPOINT_CONVERT(0)
#define MOD_EQ_INPUT1_ALG0_STAGE1_B2_TYPE              SIGMASTUDIOTYPE_FIXPOINT
#define MOD_EQ_INPUT1_ALG0_STAGE1_A0_ADDR              12
#define MOD_EQ_INPUT1_ALG0_STAGE1_A0_FIXPT             0x00000000
#define MOD_EQ_INPUT1_ALG0_STAGE1_A0_VALUE             SIGMASTUDIOTYPE_FIXPOINT_CONVERT(0)
#define MOD_EQ_INPUT1_ALG0_STAGE1_A0_TYPE              SIGMASTUDIOTYPE_FIXPOINT
#define MOD_EQ_INPUT1_ALG0_STAGE1_A1_ADDR              13
#define MOD_EQ_INPUT1_ALG0_STAGE1_A1_FIXPT             0x00000000
#define MOD_EQ_INPUT1_ALG0_STAGE1_A1_VALUE             SIGMASTUDIOTYPE_FIXPOINT_CONVERT(0)
#define MOD_EQ_INPUT1_ALG0_STAGE1_A1_TYPE              SIGMASTUDIOTYPE_FIXPOINT
#define MOD_EQ_INPUT1_ALG0_STAGE2_B0_ADDR              14
#define MOD_EQ_INPUT1_ALG0_STAGE2_B0_FIXPT             0x00800000
#define MOD_EQ_INPUT1_ALG0_STAGE2_B0_VALUE             SIGMASTUDIOTYPE_FIXPOINT_CONVERT(1)
#define MOD_EQ_INPUT1_ALG0_STAGE2_B0_TYPE              SIGMASTUDIOTYPE_FIXPOINT
#define MOD_EQ_INPUT1_ALG0_STAGE2_B1_ADDR              15
#define MOD_EQ_INPUT1_ALG0_STAGE2_B1_FIXPT             0x00000000
#define MOD_EQ_INPUT1_ALG0_STAGE2_B1_VALUE             SIGMASTUDIOTYPE_FIXPOINT_CONVERT(0)
#define MOD_EQ_INPUT1_ALG0_STAGE2_B1_TYPE              SIGMASTUDIOTYPE_FIXPOINT
#define MOD_EQ_INPUT1_ALG0_STAGE2_B2_ADDR              16
#define MOD_EQ_INPUT1_ALG0_STAGE2_B2_FIXPT             0x00000000
#define MOD_EQ_INPUT1_ALG0_STAGE2_B2_VALUE             SIGMASTUDIOTYPE_FIXPOINT_CONVERT(0)
#define MOD_EQ_INPUT1_ALG0_STAGE2_B2_TYPE              SIGMASTUDIOTYPE_FIXPOINT
#define MOD_EQ_INPUT1_ALG0_STAGE2_A0_ADDR              17
#define MOD_EQ_INPUT1_ALG0_STAGE2_A0_FIXPT             0x00000000
#define MOD_EQ_INPUT1_ALG0_STAGE2_A0_VALUE             SIGMASTUDIOTYPE_FIXPOINT_CONVERT(0)
#define MOD_EQ_INPUT1_ALG0_STAGE2_A0_TYPE              SIGMASTUDIOTYPE_FIXPOINT
#define MOD_EQ_INPUT1_ALG0_STAGE2_A1_ADDR              18
#define MOD_EQ_INPUT1_ALG0_STAGE2_A1_FIXPT             0x00000000
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
#define MOD_SELEKTOR_OUTPUT3_ALG0_STAGE1_MONOSWITCHNOSLEW_FIXPT 0x00800000
#define MOD_SELEKTOR_OUTPUT3_ALG0_STAGE1_MONOSWITCHNOSLEW_VALUE SIGMASTUDIOTYPE_FIXPOINT_CONVERT(1)
#define MOD_SELEKTOR_OUTPUT3_ALG0_STAGE1_MONOSWITCHNOSLEW_TYPE SIGMASTUDIOTYPE_FIXPOINT

/* Module selektor-output4 - Mono Switch Nx1*/
#define MOD_SELEKTOR_OUTPUT4_COUNT                     2
#define MOD_SELEKTOR_OUTPUT4_DEVICE                    "IC1"
#define MOD_SELEKTOR_OUTPUT4_ALG0_STAGE0_MONOSWITCHNOSLEW_ADDR 50
#define MOD_SELEKTOR_OUTPUT4_ALG0_STAGE0_MONOSWITCHNOSLEW_FIXPT 0x00000000
#define MOD_SELEKTOR_OUTPUT4_ALG0_STAGE0_MONOSWITCHNOSLEW_VALUE SIGMASTUDIOTYPE_FIXPOINT_CONVERT(0)
#define MOD_SELEKTOR_OUTPUT4_ALG0_STAGE0_MONOSWITCHNOSLEW_TYPE SIGMASTUDIOTYPE_FIXPOINT
#define MOD_SELEKTOR_OUTPUT4_ALG0_STAGE1_MONOSWITCHNOSLEW_ADDR 51
#define MOD_SELEKTOR_OUTPUT4_ALG0_STAGE1_MONOSWITCHNOSLEW_FIXPT 0x00800000
#define MOD_SELEKTOR_OUTPUT4_ALG0_STAGE1_MONOSWITCHNOSLEW_VALUE SIGMASTUDIOTYPE_FIXPOINT_CONVERT(1)
#define MOD_SELEKTOR_OUTPUT4_ALG0_STAGE1_MONOSWITCHNOSLEW_TYPE SIGMASTUDIOTYPE_FIXPOINT

/* Module phase-output1 - Signal Invert*/
#define MOD_PHASE_OUTPUT1_COUNT                        1
#define MOD_PHASE_OUTPUT1_DEVICE                       "IC1"
#define MOD_PHASE_OUTPUT1_EQ1940INVERT1GAIN_ADDR       52
#define MOD_PHASE_OUTPUT1_EQ1940INVERT1GAIN_FIXPT      0xFF800000
#define MOD_PHASE_OUTPUT1_EQ1940INVERT1GAIN_VALUE      SIGMASTUDIOTYPE_FIXPOINT_CONVERT(-1)
#define MOD_PHASE_OUTPUT1_EQ1940INVERT1GAIN_TYPE       SIGMASTUDIOTYPE_FIXPOINT

/* Module phase-output2 - Signal Invert*/
#define MOD_PHASE_OUTPUT2_COUNT                        1
#define MOD_PHASE_OUTPUT2_DEVICE                       "IC1"
#define MOD_PHASE_OUTPUT2_EQ1940INVERT2GAIN_ADDR       53
#define MOD_PHASE_OUTPUT2_EQ1940INVERT2GAIN_FIXPT      0xFF800000
#define MOD_PHASE_OUTPUT2_EQ1940INVERT2GAIN_VALUE      SIGMASTUDIOTYPE_FIXPOINT_CONVERT(-1)
#define MOD_PHASE_OUTPUT2_EQ1940INVERT2GAIN_TYPE       SIGMASTUDIOTYPE_FIXPOINT

/* Module phase-output3 - Signal Invert*/
#define MOD_PHASE_OUTPUT3_COUNT                        1
#define MOD_PHASE_OUTPUT3_DEVICE                       "IC1"
#define MOD_PHASE_OUTPUT3_EQ1940INVERT3GAIN_ADDR       54
#define MOD_PHASE_OUTPUT3_EQ1940INVERT3GAIN_FIXPT      0xFF800000
#define MOD_PHASE_OUTPUT3_EQ1940INVERT3GAIN_VALUE      SIGMASTUDIOTYPE_FIXPOINT_CONVERT(-1)
#define MOD_PHASE_OUTPUT3_EQ1940INVERT3GAIN_TYPE       SIGMASTUDIOTYPE_FIXPOINT

/* Module phase-output4 - Signal Invert*/
#define MOD_PHASE_OUTPUT4_COUNT                        1
#define MOD_PHASE_OUTPUT4_DEVICE                       "IC1"
#define MOD_PHASE_OUTPUT4_EQ1940INVERT4GAIN_ADDR       55
#define MOD_PHASE_OUTPUT4_EQ1940INVERT4GAIN_FIXPT      0xFF800000
#define MOD_PHASE_OUTPUT4_EQ1940INVERT4GAIN_VALUE      SIGMASTUDIOTYPE_FIXPOINT_CONVERT(-1)
#define MOD_PHASE_OUTPUT4_EQ1940INVERT4GAIN_TYPE       SIGMASTUDIOTYPE_FIXPOINT

/* Module Gain-output1 - Gain*/
#define MOD_GAIN_OUTPUT1_COUNT                         1
#define MOD_GAIN_OUTPUT1_DEVICE                        "IC1"
#define MOD_GAIN_OUTPUT1_GAIN1940ALGNS3_ADDR           56
#define MOD_GAIN_OUTPUT1_GAIN1940ALGNS3_FIXPT          0x00800000
#define MOD_GAIN_OUTPUT1_GAIN1940ALGNS3_VALUE          SIGMASTUDIOTYPE_FIXPOINT_CONVERT(1)
#define MOD_GAIN_OUTPUT1_GAIN1940ALGNS3_TYPE           SIGMASTUDIOTYPE_FIXPOINT

/* Module Gain-output2 - Gain*/
#define MOD_GAIN_OUTPUT2_COUNT                         1
#define MOD_GAIN_OUTPUT2_DEVICE                        "IC1"
#define MOD_GAIN_OUTPUT2_GAIN1940ALGNS4_ADDR           57
#define MOD_GAIN_OUTPUT2_GAIN1940ALGNS4_FIXPT          0x00800000
#define MOD_GAIN_OUTPUT2_GAIN1940ALGNS4_VALUE          SIGMASTUDIOTYPE_FIXPOINT_CONVERT(1)
#define MOD_GAIN_OUTPUT2_GAIN1940ALGNS4_TYPE           SIGMASTUDIOTYPE_FIXPOINT

/* Module Gain-output3 - Gain*/
#define MOD_GAIN_OUTPUT3_COUNT                         1
#define MOD_GAIN_OUTPUT3_DEVICE                        "IC1"
#define MOD_GAIN_OUTPUT3_GAIN1940ALGNS5_ADDR           58
#define MOD_GAIN_OUTPUT3_GAIN1940ALGNS5_FIXPT          0x00800000
#define MOD_GAIN_OUTPUT3_GAIN1940ALGNS5_VALUE          SIGMASTUDIOTYPE_FIXPOINT_CONVERT(1)
#define MOD_GAIN_OUTPUT3_GAIN1940ALGNS5_TYPE           SIGMASTUDIOTYPE_FIXPOINT

/* Module Gain-output4 - Gain*/
#define MOD_GAIN_OUTPUT4_COUNT                         1
#define MOD_GAIN_OUTPUT4_DEVICE                        "IC1"
#define MOD_GAIN_OUTPUT4_GAIN1940ALGNS6_ADDR           59
#define MOD_GAIN_OUTPUT4_GAIN1940ALGNS6_FIXPT          0x00800000
#define MOD_GAIN_OUTPUT4_GAIN1940ALGNS6_VALUE          SIGMASTUDIOTYPE_FIXPOINT_CONVERT(1)
#define MOD_GAIN_OUTPUT4_GAIN1940ALGNS6_TYPE           SIGMASTUDIOTYPE_FIXPOINT

/* Module DCB3 - DC Blocking*/
#define MOD_DCB3_COUNT                                 1
#define MOD_DCB3_DEVICE                                "IC1"
#define MOD_DCB3_DCBLOCKALGDOUBLEPREC3POLE_ADDR        60
#define MOD_DCB3_DCBLOCKALGDOUBLEPREC3POLE_FIXPT       0x007FFCB9
#define MOD_DCB3_DCBLOCKALGDOUBLEPREC3POLE_VALUE       SIGMASTUDIOTYPE_FIXPOINT_CONVERT(0.9999)
#define MOD_DCB3_DCBLOCKALGDOUBLEPREC3POLE_TYPE        SIGMASTUDIOTYPE_FIXPOINT

/* Module DCB3_2 - DC Blocking*/
#define MOD_DCB3_2_COUNT                               1
#define MOD_DCB3_2_DEVICE                              "IC1"
#define MOD_DCB3_2_DCBLOCKALGDOUBLEPREC4POLE_ADDR      61
#define MOD_DCB3_2_DCBLOCKALGDOUBLEPREC4POLE_FIXPT     0x007FFCB9
#define MOD_DCB3_2_DCBLOCKALGDOUBLEPREC4POLE_VALUE     SIGMASTUDIOTYPE_FIXPOINT_CONVERT(0.9999)
#define MOD_DCB3_2_DCBLOCKALGDOUBLEPREC4POLE_TYPE      SIGMASTUDIOTYPE_FIXPOINT

/* Module DCB3_3 - DC Blocking*/
#define MOD_DCB3_3_COUNT                               1
#define MOD_DCB3_3_DEVICE                              "IC1"
#define MOD_DCB3_3_DCBLOCKALGDOUBLEPREC5POLE_ADDR      62
#define MOD_DCB3_3_DCBLOCKALGDOUBLEPREC5POLE_FIXPT     0x007FFCB9
#define MOD_DCB3_3_DCBLOCKALGDOUBLEPREC5POLE_VALUE     SIGMASTUDIOTYPE_FIXPOINT_CONVERT(0.9999)
#define MOD_DCB3_3_DCBLOCKALGDOUBLEPREC5POLE_TYPE      SIGMASTUDIOTYPE_FIXPOINT

/* Module DCB3_4 - DC Blocking*/
#define MOD_DCB3_4_COUNT                               1
#define MOD_DCB3_4_DEVICE                              "IC1"
#define MOD_DCB3_4_DCBLOCKALGDOUBLEPREC6POLE_ADDR      63
#define MOD_DCB3_4_DCBLOCKALGDOUBLEPREC6POLE_FIXPT     0x007FFCB9
#define MOD_DCB3_4_DCBLOCKALGDOUBLEPREC6POLE_VALUE     SIGMASTUDIOTYPE_FIXPOINT_CONVERT(0.9999)
#define MOD_DCB3_4_DCBLOCKALGDOUBLEPREC6POLE_TYPE      SIGMASTUDIOTYPE_FIXPOINT

/* Module LPF-output1 - General (2nd order)*/
#define MOD_LPF_OUTPUT1_COUNT                          15
#define MOD_LPF_OUTPUT1_DEVICE                         "IC1"
#define MOD_LPF_OUTPUT1_ALG0_STAGE0_B0_ADDR            64
#define MOD_LPF_OUTPUT1_ALG0_STAGE0_B0_FIXPT           0x00800000
#define MOD_LPF_OUTPUT1_ALG0_STAGE0_B0_VALUE           SIGMASTUDIOTYPE_FIXPOINT_CONVERT(1)
#define MOD_LPF_OUTPUT1_ALG0_STAGE0_B0_TYPE            SIGMASTUDIOTYPE_FIXPOINT
#define MOD_LPF_OUTPUT1_ALG0_STAGE0_B1_ADDR            65
#define MOD_LPF_OUTPUT1_ALG0_STAGE0_B1_FIXPT           0x00000000
#define MOD_LPF_OUTPUT1_ALG0_STAGE0_B1_VALUE           SIGMASTUDIOTYPE_FIXPOINT_CONVERT(0)
#define MOD_LPF_OUTPUT1_ALG0_STAGE0_B1_TYPE            SIGMASTUDIOTYPE_FIXPOINT
#define MOD_LPF_OUTPUT1_ALG0_STAGE0_B2_ADDR            66
#define MOD_LPF_OUTPUT1_ALG0_STAGE0_B2_FIXPT           0x00000000
#define MOD_LPF_OUTPUT1_ALG0_STAGE0_B2_VALUE           SIGMASTUDIOTYPE_FIXPOINT_CONVERT(0)
#define MOD_LPF_OUTPUT1_ALG0_STAGE0_B2_TYPE            SIGMASTUDIOTYPE_FIXPOINT
#define MOD_LPF_OUTPUT1_ALG0_STAGE0_A0_ADDR            67
#define MOD_LPF_OUTPUT1_ALG0_STAGE0_A0_FIXPT           0x00000000
#define MOD_LPF_OUTPUT1_ALG0_STAGE0_A0_VALUE           SIGMASTUDIOTYPE_FIXPOINT_CONVERT(0)
#define MOD_LPF_OUTPUT1_ALG0_STAGE0_A0_TYPE            SIGMASTUDIOTYPE_FIXPOINT
#define MOD_LPF_OUTPUT1_ALG0_STAGE0_A1_ADDR            68
#define MOD_LPF_OUTPUT1_ALG0_STAGE0_A1_FIXPT           0x00000000
#define MOD_LPF_OUTPUT1_ALG0_STAGE0_A1_VALUE           SIGMASTUDIOTYPE_FIXPOINT_CONVERT(0)
#define MOD_LPF_OUTPUT1_ALG0_STAGE0_A1_TYPE            SIGMASTUDIOTYPE_FIXPOINT
#define MOD_LPF_OUTPUT1_ALG0_STAGE1_B0_ADDR            69
#define MOD_LPF_OUTPUT1_ALG0_STAGE1_B0_FIXPT           0x00800000
#define MOD_LPF_OUTPUT1_ALG0_STAGE1_B0_VALUE           SIGMASTUDIOTYPE_FIXPOINT_CONVERT(1)
#define MOD_LPF_OUTPUT1_ALG0_STAGE1_B0_TYPE            SIGMASTUDIOTYPE_FIXPOINT
#define MOD_LPF_OUTPUT1_ALG0_STAGE1_B1_ADDR            70
#define MOD_LPF_OUTPUT1_ALG0_STAGE1_B1_FIXPT           0x00000000
#define MOD_LPF_OUTPUT1_ALG0_STAGE1_B1_VALUE           SIGMASTUDIOTYPE_FIXPOINT_CONVERT(0)
#define MOD_LPF_OUTPUT1_ALG0_STAGE1_B1_TYPE            SIGMASTUDIOTYPE_FIXPOINT
#define MOD_LPF_OUTPUT1_ALG0_STAGE1_B2_ADDR            71
#define MOD_LPF_OUTPUT1_ALG0_STAGE1_B2_FIXPT           0x00000000
#define MOD_LPF_OUTPUT1_ALG0_STAGE1_B2_VALUE           SIGMASTUDIOTYPE_FIXPOINT_CONVERT(0)
#define MOD_LPF_OUTPUT1_ALG0_STAGE1_B2_TYPE            SIGMASTUDIOTYPE_FIXPOINT
#define MOD_LPF_OUTPUT1_ALG0_STAGE1_A0_ADDR            72
#define MOD_LPF_OUTPUT1_ALG0_STAGE1_A0_FIXPT           0x00000000
#define MOD_LPF_OUTPUT1_ALG0_STAGE1_A0_VALUE           SIGMASTUDIOTYPE_FIXPOINT_CONVERT(0)
#define MOD_LPF_OUTPUT1_ALG0_STAGE1_A0_TYPE            SIGMASTUDIOTYPE_FIXPOINT
#define MOD_LPF_OUTPUT1_ALG0_STAGE1_A1_ADDR            73
#define MOD_LPF_OUTPUT1_ALG0_STAGE1_A1_FIXPT           0x00000000
#define MOD_LPF_OUTPUT1_ALG0_STAGE1_A1_VALUE           SIGMASTUDIOTYPE_FIXPOINT_CONVERT(0)
#define MOD_LPF_OUTPUT1_ALG0_STAGE1_A1_TYPE            SIGMASTUDIOTYPE_FIXPOINT
#define MOD_LPF_OUTPUT1_ALG0_STAGE2_B0_ADDR            74
#define MOD_LPF_OUTPUT1_ALG0_STAGE2_B0_FIXPT           0x00800000
#define MOD_LPF_OUTPUT1_ALG0_STAGE2_B0_VALUE           SIGMASTUDIOTYPE_FIXPOINT_CONVERT(1)
#define MOD_LPF_OUTPUT1_ALG0_STAGE2_B0_TYPE            SIGMASTUDIOTYPE_FIXPOINT
#define MOD_LPF_OUTPUT1_ALG0_STAGE2_B1_ADDR            75
#define MOD_LPF_OUTPUT1_ALG0_STAGE2_B1_FIXPT           0x00000000
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
#define MOD_LPF_OUTPUT2_ALG0_STAGE1_A0_VALUE           SIGMASTUDIOTYPE_FIXPOINT_CONVERT(0)
#define MOD_LPF_OUTPUT2_ALG0_STAGE1_A0_TYPE            SIGMASTUDIOTYPE_FIXPOINT
#define MOD_LPF_OUTPUT2_ALG0_STAGE1_A1_ADDR            88
#define MOD_LPF_OUTPUT2_ALG0_STAGE1_A1_FIXPT           0x00000000
#define MOD_LPF_OUTPUT2_ALG0_STAGE1_A1_VALUE           SIGMASTUDIOTYPE_FIXPOINT_CONVERT(0)
#define MOD_LPF_OUTPUT2_ALG0_STAGE1_A1_TYPE            SIGMASTUDIOTYPE_FIXPOINT
#define MOD_LPF_OUTPUT2_ALG0_STAGE2_B0_ADDR            89
#define MOD_LPF_OUTPUT2_ALG0_STAGE2_B0_FIXPT           0x00800000
#define MOD_LPF_OUTPUT2_ALG0_STAGE2_B0_VALUE           SIGMASTUDIOTYPE_FIXPOINT_CONVERT(1)
#define MOD_LPF_OUTPUT2_ALG0_STAGE2_B0_TYPE            SIGMASTUDIOTYPE_FIXPOINT
#define MOD_LPF_OUTPUT2_ALG0_STAGE2_B1_ADDR            90
#define MOD_LPF_OUTPUT2_ALG0_STAGE2_B1_FIXPT           0x00000000
#define MOD_LPF_OUTPUT2_ALG0_STAGE2_B1_VALUE           SIGMASTUDIOTYPE_FIXPOINT_CONVERT(0)
#define MOD_LPF_OUTPUT2_ALG0_STAGE2_B1_TYPE            SIGMASTUDIOTYPE_FIXPOINT
#define MOD_LPF_OUTPUT2_ALG0_STAGE2_B2_ADDR            91
#define MOD_LPF_OUTPUT2_ALG0_STAGE2_B2_FIXPT           0x00000000
#define MOD_LPF_OUTPUT2_ALG0_STAGE2_B2_VALUE           SIGMASTUDIOTYPE_FIXPOINT_CONVERT(0)
#define MOD_LPF_OUTPUT2_ALG0_STAGE2_B2_TYPE            SIGMASTUDIOTYPE_FIXPOINT
#define MOD_LPF_OUTPUT2_ALG0_STAGE2_A0_ADDR            92
#define MOD_LPF_OUTPUT2_ALG0_STAGE2_A0_FIXPT           0x00000000
#define MOD_LPF_OUTPUT2_ALG0_STAGE2_A0_VALUE           SIGMASTUDIOTYPE_FIXPOINT_CONVERT(0)
#define MOD_LPF_OUTPUT2_ALG0_STAGE2_A0_TYPE            SIGMASTUDIOTYPE_FIXPOINT
#define MOD_LPF_OUTPUT2_ALG0_STAGE2_A1_ADDR            93
#define MOD_LPF_OUTPUT2_ALG0_STAGE2_A1_FIXPT           0x00000000
#define MOD_LPF_OUTPUT2_ALG0_STAGE2_A1_VALUE           SIGMASTUDIOTYPE_FIXPOINT_CONVERT(0)
#define MOD_LPF_OUTPUT2_ALG0_STAGE2_A1_TYPE            SIGMASTUDIOTYPE_FIXPOINT

/* Module LPF-output4 - General (2nd order)*/
#define MOD_LPF_OUTPUT4_COUNT                          15
#define MOD_LPF_OUTPUT4_DEVICE                         "IC1"
#define MOD_LPF_OUTPUT4_ALG0_STAGE0_B0_ADDR            94
#define MOD_LPF_OUTPUT4_ALG0_STAGE0_B0_FIXPT           0x00800000
#define MOD_LPF_OUTPUT4_ALG0_STAGE0_B0_VALUE           SIGMASTUDIOTYPE_FIXPOINT_CONVERT(1)
#define MOD_LPF_OUTPUT4_ALG0_STAGE0_B0_TYPE            SIGMASTUDIOTYPE_FIXPOINT
#define MOD_LPF_OUTPUT4_ALG0_STAGE0_B1_ADDR            95
#define MOD_LPF_OUTPUT4_ALG0_STAGE0_B1_FIXPT           0x00000000
#define MOD_LPF_OUTPUT4_ALG0_STAGE0_B1_VALUE           SIGMASTUDIOTYPE_FIXPOINT_CONVERT(0)
#define MOD_LPF_OUTPUT4_ALG0_STAGE0_B1_TYPE            SIGMASTUDIOTYPE_FIXPOINT
#define MOD_LPF_OUTPUT4_ALG0_STAGE0_B2_ADDR            96
#define MOD_LPF_OUTPUT4_ALG0_STAGE0_B2_FIXPT           0x00000000
#define MOD_LPF_OUTPUT4_ALG0_STAGE0_B2_VALUE           SIGMASTUDIOTYPE_FIXPOINT_CONVERT(0)
#define MOD_LPF_OUTPUT4_ALG0_STAGE0_B2_TYPE            SIGMASTUDIOTYPE_FIXPOINT
#define MOD_LPF_OUTPUT4_ALG0_STAGE0_A0_ADDR            97
#define MOD_LPF_OUTPUT4_ALG0_STAGE0_A0_FIXPT           0x00000000
#define MOD_LPF_OUTPUT4_ALG0_STAGE0_A0_VALUE           SIGMASTUDIOTYPE_FIXPOINT_CONVERT(0)
#define MOD_LPF_OUTPUT4_ALG0_STAGE0_A0_TYPE            SIGMASTUDIOTYPE_FIXPOINT
#define MOD_LPF_OUTPUT4_ALG0_STAGE0_A1_ADDR            98
#define MOD_LPF_OUTPUT4_ALG0_STAGE0_A1_FIXPT           0x00000000
#define MOD_LPF_OUTPUT4_ALG0_STAGE0_A1_VALUE           SIGMASTUDIOTYPE_FIXPOINT_CONVERT(0)
#define MOD_LPF_OUTPUT4_ALG0_STAGE0_A1_TYPE            SIGMASTUDIOTYPE_FIXPOINT
#define MOD_LPF_OUTPUT4_ALG0_STAGE1_B0_ADDR            99
#define MOD_LPF_OUTPUT4_ALG0_STAGE1_B0_FIXPT           0x00800000
#define MOD_LPF_OUTPUT4_ALG0_STAGE1_B0_VALUE           SIGMASTUDIOTYPE_FIXPOINT_CONVERT(1)
#define MOD_LPF_OUTPUT4_ALG0_STAGE1_B0_TYPE            SIGMASTUDIOTYPE_FIXPOINT
#define MOD_LPF_OUTPUT4_ALG0_STAGE1_B1_ADDR            100
#define MOD_LPF_OUTPUT4_ALG0_STAGE1_B1_FIXPT           0x00000000
#define MOD_LPF_OUTPUT4_ALG0_STAGE1_B1_VALUE           SIGMASTUDIOTYPE_FIXPOINT_CONVERT(0)
#define MOD_LPF_OUTPUT4_ALG0_STAGE1_B1_TYPE            SIGMASTUDIOTYPE_FIXPOINT
#define MOD_LPF_OUTPUT4_ALG0_STAGE1_B2_ADDR            101
#define MOD_LPF_OUTPUT4_ALG0_STAGE1_B2_FIXPT           0x00000000
#define MOD_LPF_OUTPUT4_ALG0_STAGE1_B2_VALUE           SIGMASTUDIOTYPE_FIXPOINT_CONVERT(0)
#define MOD_LPF_OUTPUT4_ALG0_STAGE1_B2_TYPE            SIGMASTUDIOTYPE_FIXPOINT
#define MOD_LPF_OUTPUT4_ALG0_STAGE1_A0_ADDR            102
#define MOD_LPF_OUTPUT4_ALG0_STAGE1_A0_FIXPT           0x00000000
#define MOD_LPF_OUTPUT4_ALG0_STAGE1_A0_VALUE           SIGMASTUDIOTYPE_FIXPOINT_CONVERT(0)
#define MOD_LPF_OUTPUT4_ALG0_STAGE1_A0_TYPE            SIGMASTUDIOTYPE_FIXPOINT
#define MOD_LPF_OUTPUT4_ALG0_STAGE1_A1_ADDR            103
#define MOD_LPF_OUTPUT4_ALG0_STAGE1_A1_FIXPT           0x00000000
#define MOD_LPF_OUTPUT4_ALG0_STAGE1_A1_VALUE           SIGMASTUDIOTYPE_FIXPOINT_CONVERT(0)
#define MOD_LPF_OUTPUT4_ALG0_STAGE1_A1_TYPE            SIGMASTUDIOTYPE_FIXPOINT
#define MOD_LPF_OUTPUT4_ALG0_STAGE2_B0_ADDR            104
#define MOD_LPF_OUTPUT4_ALG0_STAGE2_B0_FIXPT           0x00800000
#define MOD_LPF_OUTPUT4_ALG0_STAGE2_B0_VALUE           SIGMASTUDIOTYPE_FIXPOINT_CONVERT(1)
#define MOD_LPF_OUTPUT4_ALG0_STAGE2_B0_TYPE            SIGMASTUDIOTYPE_FIXPOINT
#define MOD_LPF_OUTPUT4_ALG0_STAGE2_B1_ADDR            105
#define MOD_LPF_OUTPUT4_ALG0_STAGE2_B1_FIXPT           0x00000000
#define MOD_LPF_OUTPUT4_ALG0_STAGE2_B1_VALUE           SIGMASTUDIOTYPE_FIXPOINT_CONVERT(0)
#define MOD_LPF_OUTPUT4_ALG0_STAGE2_B1_TYPE            SIGMASTUDIOTYPE_FIXPOINT
#define MOD_LPF_OUTPUT4_ALG0_STAGE2_B2_ADDR            106
#define MOD_LPF_OUTPUT4_ALG0_STAGE2_B2_FIXPT           0x00000000
#define MOD_LPF_OUTPUT4_ALG0_STAGE2_B2_VALUE           SIGMASTUDIOTYPE_FIXPOINT_CONVERT(0)
#define MOD_LPF_OUTPUT4_ALG0_STAGE2_B2_TYPE            SIGMASTUDIOTYPE_FIXPOINT
#define MOD_LPF_OUTPUT4_ALG0_STAGE2_A0_ADDR            107
#define MOD_LPF_OUTPUT4_ALG0_STAGE2_A0_FIXPT           0x00000000
#define MOD_LPF_OUTPUT4_ALG0_STAGE2_A0_VALUE           SIGMASTUDIOTYPE_FIXPOINT_CONVERT(0)
#define MOD_LPF_OUTPUT4_ALG0_STAGE2_A0_TYPE            SIGMASTUDIOTYPE_FIXPOINT
#define MOD_LPF_OUTPUT4_ALG0_STAGE2_A1_ADDR            108
#define MOD_LPF_OUTPUT4_ALG0_STAGE2_A1_FIXPT           0x00000000
#define MOD_LPF_OUTPUT4_ALG0_STAGE2_A1_VALUE           SIGMASTUDIOTYPE_FIXPOINT_CONVERT(0)
#define MOD_LPF_OUTPUT4_ALG0_STAGE2_A1_TYPE            SIGMASTUDIOTYPE_FIXPOINT

/* Module LPF-output3 - General (2nd order)*/
#define MOD_LPF_OUTPUT3_COUNT                          15
#define MOD_LPF_OUTPUT3_DEVICE                         "IC1"
#define MOD_LPF_OUTPUT3_ALG0_STAGE0_B0_ADDR            109
#define MOD_LPF_OUTPUT3_ALG0_STAGE0_B0_FIXPT           0x00800000
#define MOD_LPF_OUTPUT3_ALG0_STAGE0_B0_VALUE           SIGMASTUDIOTYPE_FIXPOINT_CONVERT(1)
#define MOD_LPF_OUTPUT3_ALG0_STAGE0_B0_TYPE            SIGMASTUDIOTYPE_FIXPOINT
#define MOD_LPF_OUTPUT3_ALG0_STAGE0_B1_ADDR            110
#define MOD_LPF_OUTPUT3_ALG0_STAGE0_B1_FIXPT           0x00000000
#define MOD_LPF_OUTPUT3_ALG0_STAGE0_B1_VALUE           SIGMASTUDIOTYPE_FIXPOINT_CONVERT(0)
#define MOD_LPF_OUTPUT3_ALG0_STAGE0_B1_TYPE            SIGMASTUDIOTYPE_FIXPOINT
#define MOD_LPF_OUTPUT3_ALG0_STAGE0_B2_ADDR            111
#define MOD_LPF_OUTPUT3_ALG0_STAGE0_B2_FIXPT           0x00000000
#define MOD_LPF_OUTPUT3_ALG0_STAGE0_B2_VALUE           SIGMASTUDIOTYPE_FIXPOINT_CONVERT(0)
#define MOD_LPF_OUTPUT3_ALG0_STAGE0_B2_TYPE            SIGMASTUDIOTYPE_FIXPOINT
#define MOD_LPF_OUTPUT3_ALG0_STAGE0_A0_ADDR            112
#define MOD_LPF_OUTPUT3_ALG0_STAGE0_A0_FIXPT           0x00000000
#define MOD_LPF_OUTPUT3_ALG0_STAGE0_A0_VALUE           SIGMASTUDIOTYPE_FIXPOINT_CONVERT(0)
#define MOD_LPF_OUTPUT3_ALG0_STAGE0_A0_TYPE            SIGMASTUDIOTYPE_FIXPOINT
#define MOD_LPF_OUTPUT3_ALG0_STAGE0_A1_ADDR            113
#define MOD_LPF_OUTPUT3_ALG0_STAGE0_A1_FIXPT           0x00000000
#define MOD_LPF_OUTPUT3_ALG0_STAGE0_A1_VALUE           SIGMASTUDIOTYPE_FIXPOINT_CONVERT(0)
#define MOD_LPF_OUTPUT3_ALG0_STAGE0_A1_TYPE            SIGMASTUDIOTYPE_FIXPOINT
#define MOD_LPF_OUTPUT3_ALG0_STAGE1_B0_ADDR            114
#define MOD_LPF_OUTPUT3_ALG0_STAGE1_B0_FIXPT           0x00800000
#define MOD_LPF_OUTPUT3_ALG0_STAGE1_B0_VALUE           SIGMASTUDIOTYPE_FIXPOINT_CONVERT(1)
#define MOD_LPF_OUTPUT3_ALG0_STAGE1_B0_TYPE            SIGMASTUDIOTYPE_FIXPOINT
#define MOD_LPF_OUTPUT3_ALG0_STAGE1_B1_ADDR            115
#define MOD_LPF_OUTPUT3_ALG0_STAGE1_B1_FIXPT           0x00000000
#define MOD_LPF_OUTPUT3_ALG0_STAGE1_B1_VALUE           SIGMASTUDIOTYPE_FIXPOINT_CONVERT(0)
#define MOD_LPF_OUTPUT3_ALG0_STAGE1_B1_TYPE            SIGMASTUDIOTYPE_FIXPOINT
#define MOD_LPF_OUTPUT3_ALG0_STAGE1_B2_ADDR            116
#define MOD_LPF_OUTPUT3_ALG0_STAGE1_B2_FIXPT           0x00000000
#define MOD_LPF_OUTPUT3_ALG0_STAGE1_B2_VALUE           SIGMASTUDIOTYPE_FIXPOINT_CONVERT(0)
#define MOD_LPF_OUTPUT3_ALG0_STAGE1_B2_TYPE            SIGMASTUDIOTYPE_FIXPOINT
#define MOD_LPF_OUTPUT3_ALG0_STAGE1_A0_ADDR            117
#define MOD_LPF_OUTPUT3_ALG0_STAGE1_A0_FIXPT           0x00000000
#define MOD_LPF_OUTPUT3_ALG0_STAGE1_A0_VALUE           SIGMASTUDIOTYPE_FIXPOINT_CONVERT(0)
#define MOD_LPF_OUTPUT3_ALG0_STAGE1_A0_TYPE            SIGMASTUDIOTYPE_FIXPOINT
#define MOD_LPF_OUTPUT3_ALG0_STAGE1_A1_ADDR            118
#define MOD_LPF_OUTPUT3_ALG0_STAGE1_A1_FIXPT           0x00000000
#define MOD_LPF_OUTPUT3_ALG0_STAGE1_A1_VALUE           SIGMASTUDIOTYPE_FIXPOINT_CONVERT(0)
#define MOD_LPF_OUTPUT3_ALG0_STAGE1_A1_TYPE            SIGMASTUDIOTYPE_FIXPOINT
#define MOD_LPF_OUTPUT3_ALG0_STAGE2_B0_ADDR            119
#define MOD_LPF_OUTPUT3_ALG0_STAGE2_B0_FIXPT           0x00800000
#define MOD_LPF_OUTPUT3_ALG0_STAGE2_B0_VALUE           SIGMASTUDIOTYPE_FIXPOINT_CONVERT(1)
#define MOD_LPF_OUTPUT3_ALG0_STAGE2_B0_TYPE            SIGMASTUDIOTYPE_FIXPOINT
#define MOD_LPF_OUTPUT3_ALG0_STAGE2_B1_ADDR            120
#define MOD_LPF_OUTPUT3_ALG0_STAGE2_B1_FIXPT           0x00000000
#define MOD_LPF_OUTPUT3_ALG0_STAGE2_B1_VALUE           SIGMASTUDIOTYPE_FIXPOINT_CONVERT(0)
#define MOD_LPF_OUTPUT3_ALG0_STAGE2_B1_TYPE            SIGMASTUDIOTYPE_FIXPOINT
#define MOD_LPF_OUTPUT3_ALG0_STAGE2_B2_ADDR            121
#define MOD_LPF_OUTPUT3_ALG0_STAGE2_B2_FIXPT           0x00000000
#define MOD_LPF_OUTPUT3_ALG0_STAGE2_B2_VALUE           SIGMASTUDIOTYPE_FIXPOINT_CONVERT(0)
#define MOD_LPF_OUTPUT3_ALG0_STAGE2_B2_TYPE            SIGMASTUDIOTYPE_FIXPOINT
#define MOD_LPF_OUTPUT3_ALG0_STAGE2_A0_ADDR            122
#define MOD_LPF_OUTPUT3_ALG0_STAGE2_A0_FIXPT           0x00000000
#define MOD_LPF_OUTPUT3_ALG0_STAGE2_A0_VALUE           SIGMASTUDIOTYPE_FIXPOINT_CONVERT(0)
#define MOD_LPF_OUTPUT3_ALG0_STAGE2_A0_TYPE            SIGMASTUDIOTYPE_FIXPOINT
#define MOD_LPF_OUTPUT3_ALG0_STAGE2_A1_ADDR            123
#define MOD_LPF_OUTPUT3_ALG0_STAGE2_A1_FIXPT           0x00000000
#define MOD_LPF_OUTPUT3_ALG0_STAGE2_A1_VALUE           SIGMASTUDIOTYPE_FIXPOINT_CONVERT(0)
#define MOD_LPF_OUTPUT3_ALG0_STAGE2_A1_TYPE            SIGMASTUDIOTYPE_FIXPOINT

/* Module HPF-output1 - General (2nd order)*/
#define MOD_HPF_OUTPUT1_COUNT                          15
#define MOD_HPF_OUTPUT1_DEVICE                         "IC1"
#define MOD_HPF_OUTPUT1_ALG0_STAGE0_B0_ADDR            124
#define MOD_HPF_OUTPUT1_ALG0_STAGE0_B0_FIXPT           0x00800000
#define MOD_HPF_OUTPUT1_ALG0_STAGE0_B0_VALUE           SIGMASTUDIOTYPE_FIXPOINT_CONVERT(1)
#define MOD_HPF_OUTPUT1_ALG0_STAGE0_B0_TYPE            SIGMASTUDIOTYPE_FIXPOINT
#define MOD_HPF_OUTPUT1_ALG0_STAGE0_B1_ADDR            125
#define MOD_HPF_OUTPUT1_ALG0_STAGE0_B1_FIXPT           0x00000000
#define MOD_HPF_OUTPUT1_ALG0_STAGE0_B1_VALUE           SIGMASTUDIOTYPE_FIXPOINT_CONVERT(0)
#define MOD_HPF_OUTPUT1_ALG0_STAGE0_B1_TYPE            SIGMASTUDIOTYPE_FIXPOINT
#define MOD_HPF_OUTPUT1_ALG0_STAGE0_B2_ADDR            126
#define MOD_HPF_OUTPUT1_ALG0_STAGE0_B2_FIXPT           0x00000000
#define MOD_HPF_OUTPUT1_ALG0_STAGE0_B2_VALUE           SIGMASTUDIOTYPE_FIXPOINT_CONVERT(0)
#define MOD_HPF_OUTPUT1_ALG0_STAGE0_B2_TYPE            SIGMASTUDIOTYPE_FIXPOINT
#define MOD_HPF_OUTPUT1_ALG0_STAGE0_A0_ADDR            127
#define MOD_HPF_OUTPUT1_ALG0_STAGE0_A0_FIXPT           0x00000000
#define MOD_HPF_OUTPUT1_ALG0_STAGE0_A0_VALUE           SIGMASTUDIOTYPE_FIXPOINT_CONVERT(0)
#define MOD_HPF_OUTPUT1_ALG0_STAGE0_A0_TYPE            SIGMASTUDIOTYPE_FIXPOINT
#define MOD_HPF_OUTPUT1_ALG0_STAGE0_A1_ADDR            128
#define MOD_HPF_OUTPUT1_ALG0_STAGE0_A1_FIXPT           0x00000000
#define MOD_HPF_OUTPUT1_ALG0_STAGE0_A1_VALUE           SIGMASTUDIOTYPE_FIXPOINT_CONVERT(0)
#define MOD_HPF_OUTPUT1_ALG0_STAGE0_A1_TYPE            SIGMASTUDIOTYPE_FIXPOINT
#define MOD_HPF_OUTPUT1_ALG0_STAGE1_B0_ADDR            129
#define MOD_HPF_OUTPUT1_ALG0_STAGE1_B0_FIXPT           0x00800000
#define MOD_HPF_OUTPUT1_ALG0_STAGE1_B0_VALUE           SIGMASTUDIOTYPE_FIXPOINT_CONVERT(1)
#define MOD_HPF_OUTPUT1_ALG0_STAGE1_B0_TYPE            SIGMASTUDIOTYPE_FIXPOINT
#define MOD_HPF_OUTPUT1_ALG0_STAGE1_B1_ADDR            130
#define MOD_HPF_OUTPUT1_ALG0_STAGE1_B1_FIXPT           0x00000000
#define MOD_HPF_OUTPUT1_ALG0_STAGE1_B1_VALUE           SIGMASTUDIOTYPE_FIXPOINT_CONVERT(0)
#define MOD_HPF_OUTPUT1_ALG0_STAGE1_B1_TYPE            SIGMASTUDIOTYPE_FIXPOINT
#define MOD_HPF_OUTPUT1_ALG0_STAGE1_B2_ADDR            131
#define MOD_HPF_OUTPUT1_ALG0_STAGE1_B2_FIXPT           0x00000000
#define MOD_HPF_OUTPUT1_ALG0_STAGE1_B2_VALUE           SIGMASTUDIOTYPE_FIXPOINT_CONVERT(0)
#define MOD_HPF_OUTPUT1_ALG0_STAGE1_B2_TYPE            SIGMASTUDIOTYPE_FIXPOINT
#define MOD_HPF_OUTPUT1_ALG0_STAGE1_A0_ADDR            132
#define MOD_HPF_OUTPUT1_ALG0_STAGE1_A0_FIXPT           0x00000000
#define MOD_HPF_OUTPUT1_ALG0_STAGE1_A0_VALUE           SIGMASTUDIOTYPE_FIXPOINT_CONVERT(0)
#define MOD_HPF_OUTPUT1_ALG0_STAGE1_A0_TYPE            SIGMASTUDIOTYPE_FIXPOINT
#define MOD_HPF_OUTPUT1_ALG0_STAGE1_A1_ADDR            133
#define MOD_HPF_OUTPUT1_ALG0_STAGE1_A1_FIXPT           0x00000000
#define MOD_HPF_OUTPUT1_ALG0_STAGE1_A1_VALUE           SIGMASTUDIOTYPE_FIXPOINT_CONVERT(0)
#define MOD_HPF_OUTPUT1_ALG0_STAGE1_A1_TYPE            SIGMASTUDIOTYPE_FIXPOINT
#define MOD_HPF_OUTPUT1_ALG0_STAGE2_B0_ADDR            134
#define MOD_HPF_OUTPUT1_ALG0_STAGE2_B0_FIXPT           0x00800000
#define MOD_HPF_OUTPUT1_ALG0_STAGE2_B0_VALUE           SIGMASTUDIOTYPE_FIXPOINT_CONVERT(1)
#define MOD_HPF_OUTPUT1_ALG0_STAGE2_B0_TYPE            SIGMASTUDIOTYPE_FIXPOINT
#define MOD_HPF_OUTPUT1_ALG0_STAGE2_B1_ADDR            135
#define MOD_HPF_OUTPUT1_ALG0_STAGE2_B1_FIXPT           0x00000000
#define MOD_HPF_OUTPUT1_ALG0_STAGE2_B1_VALUE           SIGMASTUDIOTYPE_FIXPOINT_CONVERT(0)
#define MOD_HPF_OUTPUT1_ALG0_STAGE2_B1_TYPE            SIGMASTUDIOTYPE_FIXPOINT
#define MOD_HPF_OUTPUT1_ALG0_STAGE2_B2_ADDR            136
#define MOD_HPF_OUTPUT1_ALG0_STAGE2_B2_FIXPT           0x00000000
#define MOD_HPF_OUTPUT1_ALG0_STAGE2_B2_VALUE           SIGMASTUDIOTYPE_FIXPOINT_CONVERT(0)
#define MOD_HPF_OUTPUT1_ALG0_STAGE2_B2_TYPE            SIGMASTUDIOTYPE_FIXPOINT
#define MOD_HPF_OUTPUT1_ALG0_STAGE2_A0_ADDR            137
#define MOD_HPF_OUTPUT1_ALG0_STAGE2_A0_FIXPT           0x00000000
#define MOD_HPF_OUTPUT1_ALG0_STAGE2_A0_VALUE           SIGMASTUDIOTYPE_FIXPOINT_CONVERT(0)
#define MOD_HPF_OUTPUT1_ALG0_STAGE2_A0_TYPE            SIGMASTUDIOTYPE_FIXPOINT
#define MOD_HPF_OUTPUT1_ALG0_STAGE2_A1_ADDR            138
#define MOD_HPF_OUTPUT1_ALG0_STAGE2_A1_FIXPT           0x00000000
#define MOD_HPF_OUTPUT1_ALG0_STAGE2_A1_VALUE           SIGMASTUDIOTYPE_FIXPOINT_CONVERT(0)
#define MOD_HPF_OUTPUT1_ALG0_STAGE2_A1_TYPE            SIGMASTUDIOTYPE_FIXPOINT

/* Module HPF-output2 - General (2nd order)*/
#define MOD_HPF_OUTPUT2_COUNT                          15
#define MOD_HPF_OUTPUT2_DEVICE                         "IC1"
#define MOD_HPF_OUTPUT2_ALG0_STAGE0_B0_ADDR            139
#define MOD_HPF_OUTPUT2_ALG0_STAGE0_B0_FIXPT           0x00800000
#define MOD_HPF_OUTPUT2_ALG0_STAGE0_B0_VALUE           SIGMASTUDIOTYPE_FIXPOINT_CONVERT(1)
#define MOD_HPF_OUTPUT2_ALG0_STAGE0_B0_TYPE            SIGMASTUDIOTYPE_FIXPOINT
#define MOD_HPF_OUTPUT2_ALG0_STAGE0_B1_ADDR            140
#define MOD_HPF_OUTPUT2_ALG0_STAGE0_B1_FIXPT           0x00000000
#define MOD_HPF_OUTPUT2_ALG0_STAGE0_B1_VALUE           SIGMASTUDIOTYPE_FIXPOINT_CONVERT(0)
#define MOD_HPF_OUTPUT2_ALG0_STAGE0_B1_TYPE            SIGMASTUDIOTYPE_FIXPOINT
#define MOD_HPF_OUTPUT2_ALG0_STAGE0_B2_ADDR            141
#define MOD_HPF_OUTPUT2_ALG0_STAGE0_B2_FIXPT           0x00000000
#define MOD_HPF_OUTPUT2_ALG0_STAGE0_B2_VALUE           SIGMASTUDIOTYPE_FIXPOINT_CONVERT(0)
#define MOD_HPF_OUTPUT2_ALG0_STAGE0_B2_TYPE            SIGMASTUDIOTYPE_FIXPOINT
#define MOD_HPF_OUTPUT2_ALG0_STAGE0_A0_ADDR            142
#define MOD_HPF_OUTPUT2_ALG0_STAGE0_A0_FIXPT           0x00000000
#define MOD_HPF_OUTPUT2_ALG0_STAGE0_A0_VALUE           SIGMASTUDIOTYPE_FIXPOINT_CONVERT(0)
#define MOD_HPF_OUTPUT2_ALG0_STAGE0_A0_TYPE            SIGMASTUDIOTYPE_FIXPOINT
#define MOD_HPF_OUTPUT2_ALG0_STAGE0_A1_ADDR            143
#define MOD_HPF_OUTPUT2_ALG0_STAGE0_A1_FIXPT           0x00000000
#define MOD_HPF_OUTPUT2_ALG0_STAGE0_A1_VALUE           SIGMASTUDIOTYPE_FIXPOINT_CONVERT(0)
#define MOD_HPF_OUTPUT2_ALG0_STAGE0_A1_TYPE            SIGMASTUDIOTYPE_FIXPOINT
#define MOD_HPF_OUTPUT2_ALG0_STAGE1_B0_ADDR            144
#define MOD_HPF_OUTPUT2_ALG0_STAGE1_B0_FIXPT           0x00800000
#define MOD_HPF_OUTPUT2_ALG0_STAGE1_B0_VALUE           SIGMASTUDIOTYPE_FIXPOINT_CONVERT(1)
#define MOD_HPF_OUTPUT2_ALG0_STAGE1_B0_TYPE            SIGMASTUDIOTYPE_FIXPOINT
#define MOD_HPF_OUTPUT2_ALG0_STAGE1_B1_ADDR            145
#define MOD_HPF_OUTPUT2_ALG0_STAGE1_B1_FIXPT           0x00000000
#define MOD_HPF_OUTPUT2_ALG0_STAGE1_B1_VALUE           SIGMASTUDIOTYPE_FIXPOINT_CONVERT(0)
#define MOD_HPF_OUTPUT2_ALG0_STAGE1_B1_TYPE            SIGMASTUDIOTYPE_FIXPOINT
#define MOD_HPF_OUTPUT2_ALG0_STAGE1_B2_ADDR            146
#define MOD_HPF_OUTPUT2_ALG0_STAGE1_B2_FIXPT           0x00000000
#define MOD_HPF_OUTPUT2_ALG0_STAGE1_B2_VALUE           SIGMASTUDIOTYPE_FIXPOINT_CONVERT(0)
#define MOD_HPF_OUTPUT2_ALG0_STAGE1_B2_TYPE            SIGMASTUDIOTYPE_FIXPOINT
#define MOD_HPF_OUTPUT2_ALG0_STAGE1_A0_ADDR            147
#define MOD_HPF_OUTPUT2_ALG0_STAGE1_A0_FIXPT           0x00000000
#define MOD_HPF_OUTPUT2_ALG0_STAGE1_A0_VALUE           SIGMASTUDIOTYPE_FIXPOINT_CONVERT(0)
#define MOD_HPF_OUTPUT2_ALG0_STAGE1_A0_TYPE            SIGMASTUDIOTYPE_FIXPOINT
#define MOD_HPF_OUTPUT2_ALG0_STAGE1_A1_ADDR            148
#define MOD_HPF_OUTPUT2_ALG0_STAGE1_A1_FIXPT           0x00000000
#define MOD_HPF_OUTPUT2_ALG0_STAGE1_A1_VALUE           SIGMASTUDIOTYPE_FIXPOINT_CONVERT(0)
#define MOD_HPF_OUTPUT2_ALG0_STAGE1_A1_TYPE            SIGMASTUDIOTYPE_FIXPOINT
#define MOD_HPF_OUTPUT2_ALG0_STAGE2_B0_ADDR            149
#define MOD_HPF_OUTPUT2_ALG0_STAGE2_B0_FIXPT           0x00800000
#define MOD_HPF_OUTPUT2_ALG0_STAGE2_B0_VALUE           SIGMASTUDIOTYPE_FIXPOINT_CONVERT(1)
#define MOD_HPF_OUTPUT2_ALG0_STAGE2_B0_TYPE            SIGMASTUDIOTYPE_FIXPOINT
#define MOD_HPF_OUTPUT2_ALG0_STAGE2_B1_ADDR            150
#define MOD_HPF_OUTPUT2_ALG0_STAGE2_B1_FIXPT           0x00000000
#define MOD_HPF_OUTPUT2_ALG0_STAGE2_B1_VALUE           SIGMASTUDIOTYPE_FIXPOINT_CONVERT(0)
#define MOD_HPF_OUTPUT2_ALG0_STAGE2_B1_TYPE            SIGMASTUDIOTYPE_FIXPOINT
#define MOD_HPF_OUTPUT2_ALG0_STAGE2_B2_ADDR            151
#define MOD_HPF_OUTPUT2_ALG0_STAGE2_B2_FIXPT           0x00000000
#define MOD_HPF_OUTPUT2_ALG0_STAGE2_B2_VALUE           SIGMASTUDIOTYPE_FIXPOINT_CONVERT(0)
#define MOD_HPF_OUTPUT2_ALG0_STAGE2_B2_TYPE            SIGMASTUDIOTYPE_FIXPOINT
#define MOD_HPF_OUTPUT2_ALG0_STAGE2_A0_ADDR            152
#define MOD_HPF_OUTPUT2_ALG0_STAGE2_A0_FIXPT           0x00000000
#define MOD_HPF_OUTPUT2_ALG0_STAGE2_A0_VALUE           SIGMASTUDIOTYPE_FIXPOINT_CONVERT(0)
#define MOD_HPF_OUTPUT2_ALG0_STAGE2_A0_TYPE            SIGMASTUDIOTYPE_FIXPOINT
#define MOD_HPF_OUTPUT2_ALG0_STAGE2_A1_ADDR            153
#define MOD_HPF_OUTPUT2_ALG0_STAGE2_A1_FIXPT           0x00000000
#define MOD_HPF_OUTPUT2_ALG0_STAGE2_A1_VALUE           SIGMASTUDIOTYPE_FIXPOINT_CONVERT(0)
#define MOD_HPF_OUTPUT2_ALG0_STAGE2_A1_TYPE            SIGMASTUDIOTYPE_FIXPOINT

/* Module HPF-output4 - General (2nd order)*/
#define MOD_HPF_OUTPUT4_COUNT                          15
#define MOD_HPF_OUTPUT4_DEVICE                         "IC1"
#define MOD_HPF_OUTPUT4_ALG0_STAGE0_B0_ADDR            154
#define MOD_HPF_OUTPUT4_ALG0_STAGE0_B0_FIXPT           0x00800000
#define MOD_HPF_OUTPUT4_ALG0_STAGE0_B0_VALUE           SIGMASTUDIOTYPE_FIXPOINT_CONVERT(1)
#define MOD_HPF_OUTPUT4_ALG0_STAGE0_B0_TYPE            SIGMASTUDIOTYPE_FIXPOINT
#define MOD_HPF_OUTPUT4_ALG0_STAGE0_B1_ADDR            155
#define MOD_HPF_OUTPUT4_ALG0_STAGE0_B1_FIXPT           0x00000000
#define MOD_HPF_OUTPUT4_ALG0_STAGE0_B1_VALUE           SIGMASTUDIOTYPE_FIXPOINT_CONVERT(0)
#define MOD_HPF_OUTPUT4_ALG0_STAGE0_B1_TYPE            SIGMASTUDIOTYPE_FIXPOINT
#define MOD_HPF_OUTPUT4_ALG0_STAGE0_B2_ADDR            156
#define MOD_HPF_OUTPUT4_ALG0_STAGE0_B2_FIXPT           0x00000000
#define MOD_HPF_OUTPUT4_ALG0_STAGE0_B2_VALUE           SIGMASTUDIOTYPE_FIXPOINT_CONVERT(0)
#define MOD_HPF_OUTPUT4_ALG0_STAGE0_B2_TYPE            SIGMASTUDIOTYPE_FIXPOINT
#define MOD_HPF_OUTPUT4_ALG0_STAGE0_A0_ADDR            157
#define MOD_HPF_OUTPUT4_ALG0_STAGE0_A0_FIXPT           0x00000000
#define MOD_HPF_OUTPUT4_ALG0_STAGE0_A0_VALUE           SIGMASTUDIOTYPE_FIXPOINT_CONVERT(0)
#define MOD_HPF_OUTPUT4_ALG0_STAGE0_A0_TYPE            SIGMASTUDIOTYPE_FIXPOINT
#define MOD_HPF_OUTPUT4_ALG0_STAGE0_A1_ADDR            158
#define MOD_HPF_OUTPUT4_ALG0_STAGE0_A1_FIXPT           0x00000000
#define MOD_HPF_OUTPUT4_ALG0_STAGE0_A1_VALUE           SIGMASTUDIOTYPE_FIXPOINT_CONVERT(0)
#define MOD_HPF_OUTPUT4_ALG0_STAGE0_A1_TYPE            SIGMASTUDIOTYPE_FIXPOINT
#define MOD_HPF_OUTPUT4_ALG0_STAGE1_B0_ADDR            159
#define MOD_HPF_OUTPUT4_ALG0_STAGE1_B0_FIXPT           0x00800000
#define MOD_HPF_OUTPUT4_ALG0_STAGE1_B0_VALUE           SIGMASTUDIOTYPE_FIXPOINT_CONVERT(1)
#define MOD_HPF_OUTPUT4_ALG0_STAGE1_B0_TYPE            SIGMASTUDIOTYPE_FIXPOINT
#define MOD_HPF_OUTPUT4_ALG0_STAGE1_B1_ADDR            160
#define MOD_HPF_OUTPUT4_ALG0_STAGE1_B1_FIXPT           0x00000000
#define MOD_HPF_OUTPUT4_ALG0_STAGE1_B1_VALUE           SIGMASTUDIOTYPE_FIXPOINT_CONVERT(0)
#define MOD_HPF_OUTPUT4_ALG0_STAGE1_B1_TYPE            SIGMASTUDIOTYPE_FIXPOINT
#define MOD_HPF_OUTPUT4_ALG0_STAGE1_B2_ADDR            161
#define MOD_HPF_OUTPUT4_ALG0_STAGE1_B2_FIXPT           0x00000000
#define MOD_HPF_OUTPUT4_ALG0_STAGE1_B2_VALUE           SIGMASTUDIOTYPE_FIXPOINT_CONVERT(0)
#define MOD_HPF_OUTPUT4_ALG0_STAGE1_B2_TYPE            SIGMASTUDIOTYPE_FIXPOINT
#define MOD_HPF_OUTPUT4_ALG0_STAGE1_A0_ADDR            162
#define MOD_HPF_OUTPUT4_ALG0_STAGE1_A0_FIXPT           0x00000000
#define MOD_HPF_OUTPUT4_ALG0_STAGE1_A0_VALUE           SIGMASTUDIOTYPE_FIXPOINT_CONVERT(0)
#define MOD_HPF_OUTPUT4_ALG0_STAGE1_A0_TYPE            SIGMASTUDIOTYPE_FIXPOINT
#define MOD_HPF_OUTPUT4_ALG0_STAGE1_A1_ADDR            163
#define MOD_HPF_OUTPUT4_ALG0_STAGE1_A1_FIXPT           0x00000000
#define MOD_HPF_OUTPUT4_ALG0_STAGE1_A1_VALUE           SIGMASTUDIOTYPE_FIXPOINT_CONVERT(0)
#define MOD_HPF_OUTPUT4_ALG0_STAGE1_A1_TYPE            SIGMASTUDIOTYPE_FIXPOINT
#define MOD_HPF_OUTPUT4_ALG0_STAGE2_B0_ADDR            164
#define MOD_HPF_OUTPUT4_ALG0_STAGE2_B0_FIXPT           0x00800000
#define MOD_HPF_OUTPUT4_ALG0_STAGE2_B0_VALUE           SIGMASTUDIOTYPE_FIXPOINT_CONVERT(1)
#define MOD_HPF_OUTPUT4_ALG0_STAGE2_B0_TYPE            SIGMASTUDIOTYPE_FIXPOINT
#define MOD_HPF_OUTPUT4_ALG0_STAGE2_B1_ADDR            165
#define MOD_HPF_OUTPUT4_ALG0_STAGE2_B1_FIXPT           0x00000000
#define MOD_HPF_OUTPUT4_ALG0_STAGE2_B1_VALUE           SIGMASTUDIOTYPE_FIXPOINT_CONVERT(0)
#define MOD_HPF_OUTPUT4_ALG0_STAGE2_B1_TYPE            SIGMASTUDIOTYPE_FIXPOINT
#define MOD_HPF_OUTPUT4_ALG0_STAGE2_B2_ADDR            166
#define MOD_HPF_OUTPUT4_ALG0_STAGE2_B2_FIXPT           0x00000000
#define MOD_HPF_OUTPUT4_ALG0_STAGE2_B2_VALUE           SIGMASTUDIOTYPE_FIXPOINT_CONVERT(0)
#define MOD_HPF_OUTPUT4_ALG0_STAGE2_B2_TYPE            SIGMASTUDIOTYPE_FIXPOINT
#define MOD_HPF_OUTPUT4_ALG0_STAGE2_A0_ADDR            167
#define MOD_HPF_OUTPUT4_ALG0_STAGE2_A0_FIXPT           0x00000000
#define MOD_HPF_OUTPUT4_ALG0_STAGE2_A0_VALUE           SIGMASTUDIOTYPE_FIXPOINT_CONVERT(0)
#define MOD_HPF_OUTPUT4_ALG0_STAGE2_A0_TYPE            SIGMASTUDIOTYPE_FIXPOINT
#define MOD_HPF_OUTPUT4_ALG0_STAGE2_A1_ADDR            168
#define MOD_HPF_OUTPUT4_ALG0_STAGE2_A1_FIXPT           0x00000000
#define MOD_HPF_OUTPUT4_ALG0_STAGE2_A1_VALUE           SIGMASTUDIOTYPE_FIXPOINT_CONVERT(0)
#define MOD_HPF_OUTPUT4_ALG0_STAGE2_A1_TYPE            SIGMASTUDIOTYPE_FIXPOINT

/* Module HPF-output3 - General (2nd order)*/
#define MOD_HPF_OUTPUT3_COUNT                          15
#define MOD_HPF_OUTPUT3_DEVICE                         "IC1"
#define MOD_HPF_OUTPUT3_ALG0_STAGE0_B0_ADDR            169
#define MOD_HPF_OUTPUT3_ALG0_STAGE0_B0_FIXPT           0x00800000
#define MOD_HPF_OUTPUT3_ALG0_STAGE0_B0_VALUE           SIGMASTUDIOTYPE_FIXPOINT_CONVERT(1)
#define MOD_HPF_OUTPUT3_ALG0_STAGE0_B0_TYPE            SIGMASTUDIOTYPE_FIXPOINT
#define MOD_HPF_OUTPUT3_ALG0_STAGE0_B1_ADDR            170
#define MOD_HPF_OUTPUT3_ALG0_STAGE0_B1_FIXPT           0x00000000
#define MOD_HPF_OUTPUT3_ALG0_STAGE0_B1_VALUE           SIGMASTUDIOTYPE_FIXPOINT_CONVERT(0)
#define MOD_HPF_OUTPUT3_ALG0_STAGE0_B1_TYPE            SIGMASTUDIOTYPE_FIXPOINT
#define MOD_HPF_OUTPUT3_ALG0_STAGE0_B2_ADDR            171
#define MOD_HPF_OUTPUT3_ALG0_STAGE0_B2_FIXPT           0x00000000
#define MOD_HPF_OUTPUT3_ALG0_STAGE0_B2_VALUE           SIGMASTUDIOTYPE_FIXPOINT_CONVERT(0)
#define MOD_HPF_OUTPUT3_ALG0_STAGE0_B2_TYPE            SIGMASTUDIOTYPE_FIXPOINT
#define MOD_HPF_OUTPUT3_ALG0_STAGE0_A0_ADDR            172
#define MOD_HPF_OUTPUT3_ALG0_STAGE0_A0_FIXPT           0x00000000
#define MOD_HPF_OUTPUT3_ALG0_STAGE0_A0_VALUE           SIGMASTUDIOTYPE_FIXPOINT_CONVERT(0)
#define MOD_HPF_OUTPUT3_ALG0_STAGE0_A0_TYPE            SIGMASTUDIOTYPE_FIXPOINT
#define MOD_HPF_OUTPUT3_ALG0_STAGE0_A1_ADDR            173
#define MOD_HPF_OUTPUT3_ALG0_STAGE0_A1_FIXPT           0x00000000
#define MOD_HPF_OUTPUT3_ALG0_STAGE0_A1_VALUE           SIGMASTUDIOTYPE_FIXPOINT_CONVERT(0)
#define MOD_HPF_OUTPUT3_ALG0_STAGE0_A1_TYPE            SIGMASTUDIOTYPE_FIXPOINT
#define MOD_HPF_OUTPUT3_ALG0_STAGE1_B0_ADDR            174
#define MOD_HPF_OUTPUT3_ALG0_STAGE1_B0_FIXPT           0x00800000
#define MOD_HPF_OUTPUT3_ALG0_STAGE1_B0_VALUE           SIGMASTUDIOTYPE_FIXPOINT_CONVERT(1)
#define MOD_HPF_OUTPUT3_ALG0_STAGE1_B0_TYPE            SIGMASTUDIOTYPE_FIXPOINT
#define MOD_HPF_OUTPUT3_ALG0_STAGE1_B1_ADDR            175
#define MOD_HPF_OUTPUT3_ALG0_STAGE1_B1_FIXPT           0x00000000
#define MOD_HPF_OUTPUT3_ALG0_STAGE1_B1_VALUE           SIGMASTUDIOTYPE_FIXPOINT_CONVERT(0)
#define MOD_HPF_OUTPUT3_ALG0_STAGE1_B1_TYPE            SIGMASTUDIOTYPE_FIXPOINT
#define MOD_HPF_OUTPUT3_ALG0_STAGE1_B2_ADDR            176
#define MOD_HPF_OUTPUT3_ALG0_STAGE1_B2_FIXPT           0x00000000
#define MOD_HPF_OUTPUT3_ALG0_STAGE1_B2_VALUE           SIGMASTUDIOTYPE_FIXPOINT_CONVERT(0)
#define MOD_HPF_OUTPUT3_ALG0_STAGE1_B2_TYPE            SIGMASTUDIOTYPE_FIXPOINT
#define MOD_HPF_OUTPUT3_ALG0_STAGE1_A0_ADDR            177
#define MOD_HPF_OUTPUT3_ALG0_STAGE1_A0_FIXPT           0x00000000
#define MOD_HPF_OUTPUT3_ALG0_STAGE1_A0_VALUE           SIGMASTUDIOTYPE_FIXPOINT_CONVERT(0)
#define MOD_HPF_OUTPUT3_ALG0_STAGE1_A0_TYPE            SIGMASTUDIOTYPE_FIXPOINT
#define MOD_HPF_OUTPUT3_ALG0_STAGE1_A1_ADDR            178
#define MOD_HPF_OUTPUT3_ALG0_STAGE1_A1_FIXPT           0x00000000
#define MOD_HPF_OUTPUT3_ALG0_STAGE1_A1_VALUE           SIGMASTUDIOTYPE_FIXPOINT_CONVERT(0)
#define MOD_HPF_OUTPUT3_ALG0_STAGE1_A1_TYPE            SIGMASTUDIOTYPE_FIXPOINT
#define MOD_HPF_OUTPUT3_ALG0_STAGE2_B0_ADDR            179
#define MOD_HPF_OUTPUT3_ALG0_STAGE2_B0_FIXPT           0x00800000
#define MOD_HPF_OUTPUT3_ALG0_STAGE2_B0_VALUE           SIGMASTUDIOTYPE_FIXPOINT_CONVERT(1)
#define MOD_HPF_OUTPUT3_ALG0_STAGE2_B0_TYPE            SIGMASTUDIOTYPE_FIXPOINT
#define MOD_HPF_OUTPUT3_ALG0_STAGE2_B1_ADDR            180
#define MOD_HPF_OUTPUT3_ALG0_STAGE2_B1_FIXPT           0x00000000
#define MOD_HPF_OUTPUT3_ALG0_STAGE2_B1_VALUE           SIGMASTUDIOTYPE_FIXPOINT_CONVERT(0)
#define MOD_HPF_OUTPUT3_ALG0_STAGE2_B1_TYPE            SIGMASTUDIOTYPE_FIXPOINT
#define MOD_HPF_OUTPUT3_ALG0_STAGE2_B2_ADDR            181
#define MOD_HPF_OUTPUT3_ALG0_STAGE2_B2_FIXPT           0x00000000
#define MOD_HPF_OUTPUT3_ALG0_STAGE2_B2_VALUE           SIGMASTUDIOTYPE_FIXPOINT_CONVERT(0)
#define MOD_HPF_OUTPUT3_ALG0_STAGE2_B2_TYPE            SIGMASTUDIOTYPE_FIXPOINT
#define MOD_HPF_OUTPUT3_ALG0_STAGE2_A0_ADDR            182
#define MOD_HPF_OUTPUT3_ALG0_STAGE2_A0_FIXPT           0x00000000
#define MOD_HPF_OUTPUT3_ALG0_STAGE2_A0_VALUE           SIGMASTUDIOTYPE_FIXPOINT_CONVERT(0)
#define MOD_HPF_OUTPUT3_ALG0_STAGE2_A0_TYPE            SIGMASTUDIOTYPE_FIXPOINT
#define MOD_HPF_OUTPUT3_ALG0_STAGE2_A1_ADDR            183
#define MOD_HPF_OUTPUT3_ALG0_STAGE2_A1_FIXPT           0x00000000
#define MOD_HPF_OUTPUT3_ALG0_STAGE2_A1_VALUE           SIGMASTUDIOTYPE_FIXPOINT_CONVERT(0)
#define MOD_HPF_OUTPUT3_ALG0_STAGE2_A1_TYPE            SIGMASTUDIOTYPE_FIXPOINT

/* Module Limiter-1 - RMS Detect (no:gain,hold,decay)*/
#define MOD_LIMITER_1_COUNT                            35
#define MOD_LIMITER_1_DEVICE                           "IC1"
#define MOD_LIMITER_1_ALG0_MONONOPOSTGAINNOHOLDNODELAY10_ADDR 184
#define MOD_LIMITER_1_ALG0_MONONOPOSTGAINNOHOLDNODELAY10_FIXPT 0x00800000
#define MOD_LIMITER_1_ALG0_MONONOPOSTGAINNOHOLDNODELAY10_VALUE SIGMASTUDIOTYPE_FIXPOINT_CONVERT(1)
#define MOD_LIMITER_1_ALG0_MONONOPOSTGAINNOHOLDNODELAY10_TYPE SIGMASTUDIOTYPE_FIXPOINT
#define MOD_LIMITER_1_ALG0_MONONOPOSTGAINNOHOLDNODELAY11_ADDR 185
#define MOD_LIMITER_1_ALG0_MONONOPOSTGAINNOHOLDNODELAY11_FIXPT 0x00800000
#define MOD_LIMITER_1_ALG0_MONONOPOSTGAINNOHOLDNODELAY11_VALUE SIGMASTUDIOTYPE_FIXPOINT_CONVERT(1)
#define MOD_LIMITER_1_ALG0_MONONOPOSTGAINNOHOLDNODELAY11_TYPE SIGMASTUDIOTYPE_FIXPOINT
#define MOD_LIMITER_1_ALG0_MONONOPOSTGAINNOHOLDNODELAY12_ADDR 186
#define MOD_LIMITER_1_ALG0_MONONOPOSTGAINNOHOLDNODELAY12_FIXPT 0x00800000
#define MOD_LIMITER_1_ALG0_MONONOPOSTGAINNOHOLDNODELAY12_VALUE SIGMASTUDIOTYPE_FIXPOINT_CONVERT(1)
#define MOD_LIMITER_1_ALG0_MONONOPOSTGAINNOHOLDNODELAY12_TYPE SIGMASTUDIOTYPE_FIXPOINT
#define MOD_LIMITER_1_ALG0_MONONOPOSTGAINNOHOLDNODELAY13_ADDR 187
#define MOD_LIMITER_1_ALG0_MONONOPOSTGAINNOHOLDNODELAY13_FIXPT 0x00800000
#define MOD_LIMITER_1_ALG0_MONONOPOSTGAINNOHOLDNODELAY13_VALUE SIGMASTUDIOTYPE_FIXPOINT_CONVERT(1)
#define MOD_LIMITER_1_ALG0_MONONOPOSTGAINNOHOLDNODELAY13_TYPE SIGMASTUDIOTYPE_FIXPOINT
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
#define MOD_LIMITER_4_ALG0_MONONOPOSTGAINNOHOLDNODELAY4RMS_FIXPT 0x00004EB0
#define MOD_LIMITER_4_ALG0_MONONOPOSTGAINNOHOLDNODELAY4RMS_VALUE SIGMASTUDIOTYPE_FIXPOINT_CONVERT(0.00240140490349172)
#define MOD_LIMITER_4_ALG0_MONONOPOSTGAINNOHOLDNODELAY4RMS_TYPE SIGMASTUDIOTYPE_FIXPOINT

#endif
